edgecollective/uv254/hardware/uv-control/README.md

# UV-Control

Controller board. **v0.4 is in progress on `main`, restarted from Rook v0.4**
(Edge Collective's validated Pro Micro nRF52840 board): its Pro Micro, ST7789
display, buttons and microSD, plus an ADS1115 ADC, JST connectors to the emitter
and detector, and test points. The boost for the UV LED is still to be added. See
[`v0.4-design.md`](v0.4-design.md) for the pin map and what's left to do. The
first v0.4 draft is in [`reference/v0.4-draft`](reference/v0.4-draft).

v0.1 (fabricated in 2024) used an Adafruit ItsyBitsy nRF52840 Express, an
SSD1306 OLED display, push buttons and a 555-based boost circuit.

Firmware is in [`firmware/uv-control`](../../firmware/uv-control). The v0.4
bring-up code is in its [`v0.4`](../../firmware/uv-control/v0.4) folder.

Open `uv-control.kicad_pro` in KiCad 10. Custom parts come from
[`lib/`](../../lib).

**[Download the KiCad files (zip)](https://github.com/edgecollective/uv254/archive/refs/heads/main.zip)**: the whole repository as it is on
`main`, because the board needs the shared `lib/` folder. This board is in
`hardware/uv-control/`.

<!-- render-images:start -->
<!-- Generated by scripts/render-images.sh. Edits between these markers are overwritten. -->

## Schematic

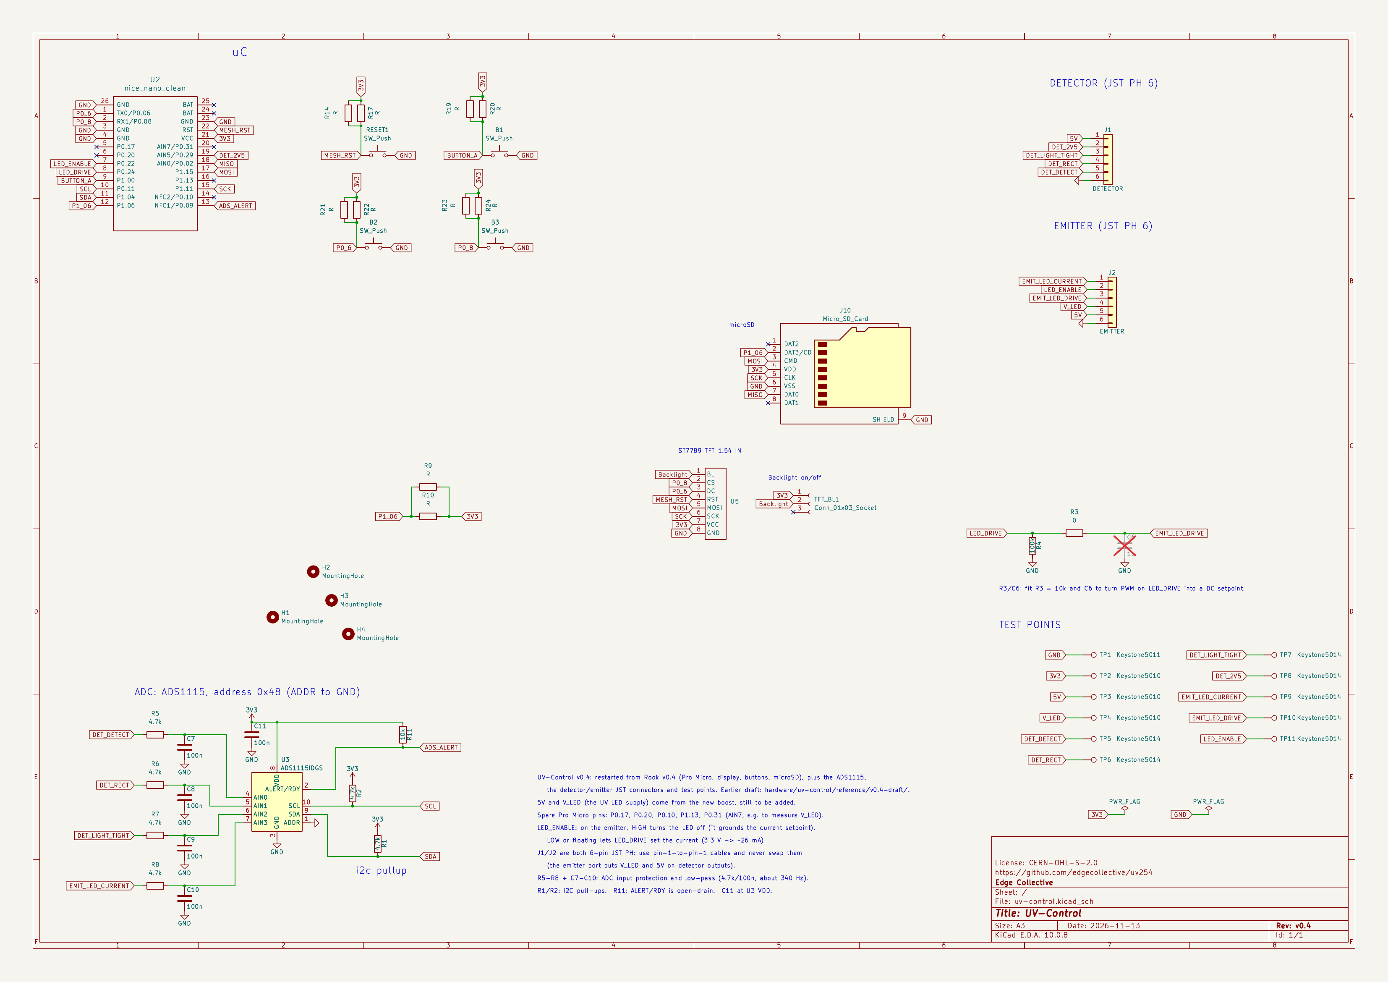
[picture p8: hardware/uv-control/docs/uv-control-schematic.png]
UV-Control schematic


Click the image for the [PDF](docs/uv-control-schematic.pdf).

## Board layout

Copper and silkscreen. The back is mirrored, as seen from below.

| Front | Back |
|:---:|:---:|
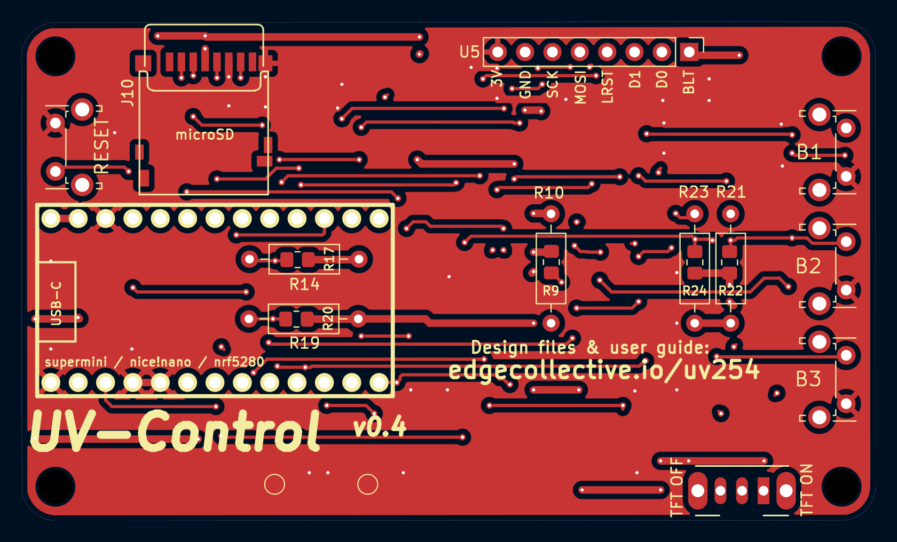
[picture p9: hardware/uv-control/docs/uv-control-pcb-front.png]
UV-Control PCB, front
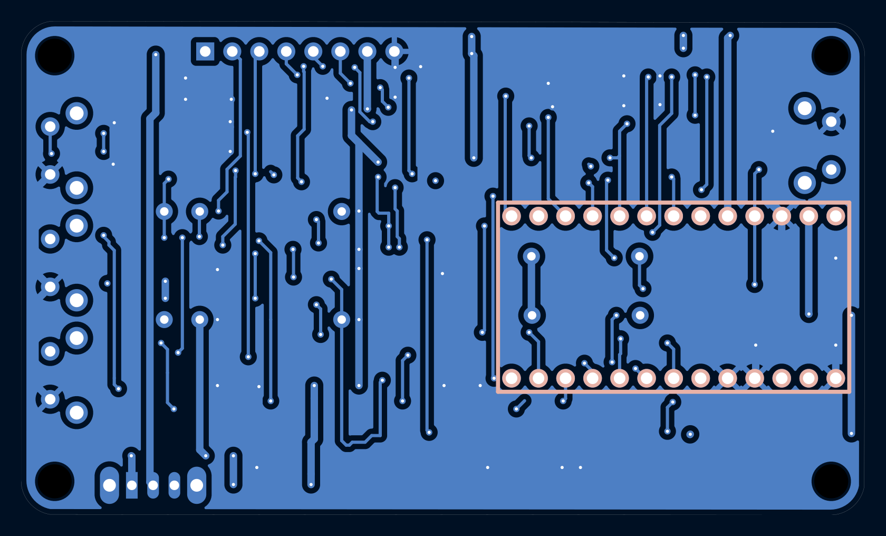
[picture p10: hardware/uv-control/docs/uv-control-pcb-back.png]
UV-Control PCB, back
|  |  |

## 3D view

| Front | Back |
|:---:|:---:|
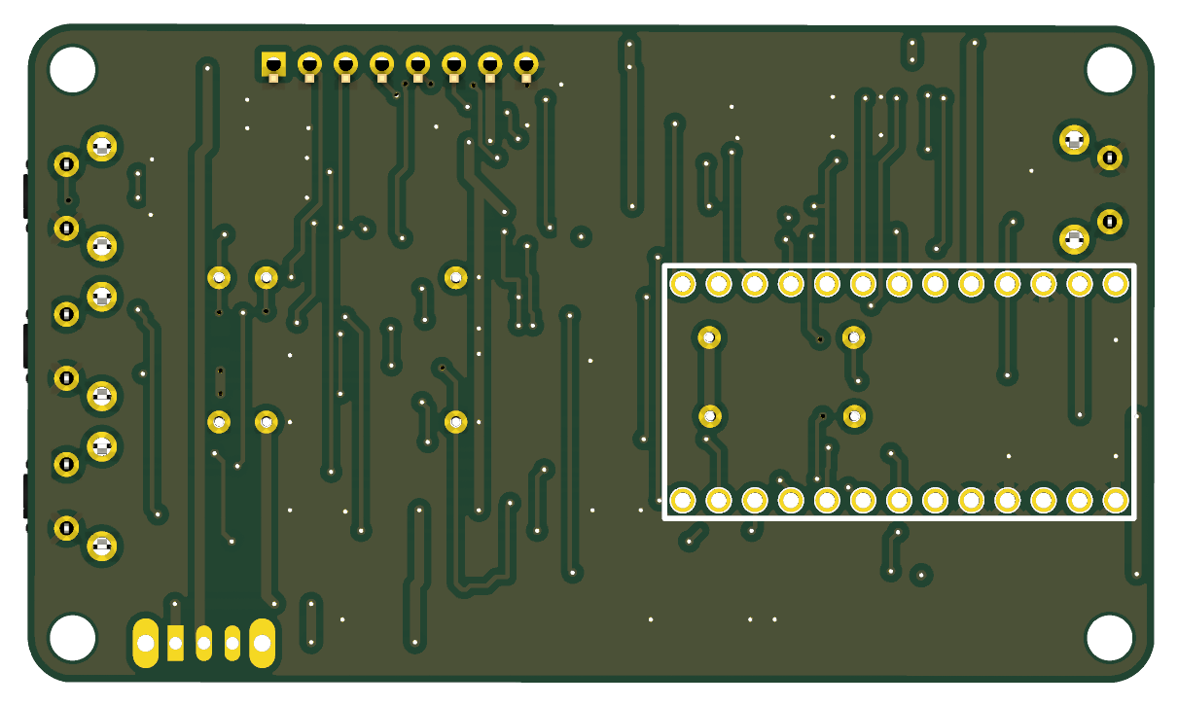
[picture p11: hardware/uv-control/docs/uv-control-3d-back.png]
UV-Control 3D render, back
| UV-Control 3D render, front |  |

Images of the current design, made with `scripts/render-images.sh uv-control`.
Re-run it after changing the board; see
[Updating the board images](../../README.md#updating-the-board-images).
<!-- render-images:end -->

## Revisions

| Version | Date | Status | Design | Fab files |
|---|---|---|---|---|
| v0.1 | 2024-07-29 | gerbers released; ordered from JLCPCB on 2024-08-19 | tag `uv-control/v0.1` | [`fab/v0.1`](fab/v0.1) |
| v0.1_A | 2026-06-26 | branched from v0.1; sent to Josh | tag `uv-control/v0.1_A` | — |
| v0.1_A+ | 2026-10 | edits made after v0.1_A was sent; never fabricated; superseded by v0.4 | commit `db4232b` | — |
| **v0.4** | 2026-11 | **in progress on `main`**: first-draft schematic; layout not started | `main` | — |

Notes:

- **v0.1_A+** isn't tagged. To get it back: `git checkout db4232b -- hardware/uv-control`.
  Its silkscreen points to `gitlab.com/edgecollective/uv-water/` and reads
  `UV-Control v0.1 / July 2024`.
