edgecollective/uv254/hardware/uv-emitter/fab/v0.4/uv-emitter-v0.4-bom.csv

Refs | Value | Footprint | Qty | DNP | Description
CX1 | 0.1 uF | Capacitor_SMD:C_0805_2012Metric_Pad1.18x1.45mm_HandSolder | 1 |  | Unpolarized capacitor
CX2 | 1 uF | Capacitor_SMD:C_0805_2012Metric_Pad1.18x1.45mm_HandSolder | 1 |  | Unpolarized capacitor
D1 | UV LED | uv254:LED_IN-C35PPCTGU0 | 1
H1,H2,H3,H4 | MountingHole | MountingHole:MountingHole_3.2mm_M3 | 4 |  | Mounting Hole without connection
J1 | Conn_01x06_Socket | Connector_PinSocket_2.54mm:PinSocket_1x06_P2.54mm_Vertical | 1 |  | Generic connector, single row, 01x06, script generated
J2 | Conn_01x06_Socket | Connector_JST:JST_PH_B6B-PH-K_1x06_P2.00mm_Vertical | 1 |  | Generic connector, single row, 01x06, script generated
Q1,Q2 | 2N7000 | Package_TO_SOT_SMD:SOT-23 | 2 |  | 0.2A Id, 200V Vds, N-Channel MOSFET, 2.6V Logic Level, TO-92
R1 | 49.9 | Resistor_SMD:R_0805_2012Metric_Pad1.20x1.40mm_HandSolder | 1
R2 | 24.9 | Resistor_SMD:R_0805_2012Metric_Pad1.20x1.40mm_HandSolder | 1
R3 | 100K | Resistor_SMD:R_0805_2012Metric_Pad1.20x1.40mm_HandSolder | 1
R4 | 24.9K | Resistor_SMD:R_0805_2012Metric_Pad1.20x1.40mm_HandSolder | 1
R5 | 10K | Resistor_SMD:R_0805_2012Metric_Pad1.20x1.40mm_HandSolder | 1
U1 | OPA4340UA | Package_SO:SOIC-14_3.9x8.7mm_P1.27mm | 1 |  | Quad Single-Supply, Rail-to-Rail Operational Amplifier, MicroAmplifier Series, SOIC-14
