edgecollective/uv254/hardware/uv-detector/fab/v0.4/uv-detector-v0.4-bom.csv

Refs | Value | Footprint | Qty | DNP | Description
C1,C3,CX4,CX5 | 1uF | Capacitor_SMD:C_0805_2012Metric_Pad1.18x1.45mm_HandSolder | 4
C2 | 10pF | Capacitor_SMD:C_0805_2012Metric_Pad1.18x1.45mm_HandSolder | 1
C4,C5 | 0.1uF | Capacitor_SMD:C_0805_2012Metric_Pad1.18x1.45mm_HandSolder | 2
D1 | BAT54S | Package_TO_SOT_SMD:SOT-23 | 1
D2 | SD008-2171-112 | Package_TO_SOT_THT:TO-18-3 | 1 |  | Si PIN Photodiode, 0.1 GHz, TO-18-3
H1,H2,H3,H4 | MountingHole | MountingHole:MountingHole_3.2mm_M3 | 4 |  | Mounting Hole without connection
J1 | Conn_01x06_Male | Connector_PinHeader_2.54mm:PinHeader_1x06_P2.54mm_Vertical | 1 |  | Generic connector, single row, 01x06, script generated (kicad-library-utils/schlib/autogen/connector/)
J2 | Conn_01x06_Male | Connector_JST:JST_PH_B6B-PH-K_1x06_P2.00mm_Vertical | 1 |  | Generic connector, single row, 01x06, script generated (kicad-library-utils/schlib/autogen/connector/)
R1,R2,R3,R5,R7,R9,R11 | 10K | Resistor_SMD:R_0805_2012Metric_Pad1.20x1.40mm_HandSolder | 7
R4,R15 | 4.99K | Resistor_SMD:R_0805_2012Metric_Pad1.20x1.40mm_HandSolder | 2
R8 | 1Meg | Resistor_SMD:R_0805_2012Metric_Pad1.20x1.40mm_HandSolder | 1
R14,RX13 | 1K | Resistor_SMD:R_0805_2012Metric_Pad1.20x1.40mm_HandSolder | 2
RX6 | 100K | Resistor_SMD:R_0805_2012Metric_Pad1.20x1.40mm_HandSolder | 1
RX10,RX12 | 43.2K | Resistor_SMD:R_0805_2012Metric_Pad1.20x1.40mm_HandSolder | 2
U1 | OPA4340UA | Package_SO:SOIC-14_3.9x8.7mm_P1.27mm | 1
U2 | LM4040DBZ-2.5 | Package_TO_SOT_SMD:SOT-23 | 1 |  | 2.500V Precision Micropower Shunt Voltage Reference, SOT-23
