edgecollective/uv254/hardware/uv-detector/docs/uv-detector-schematic.pdf

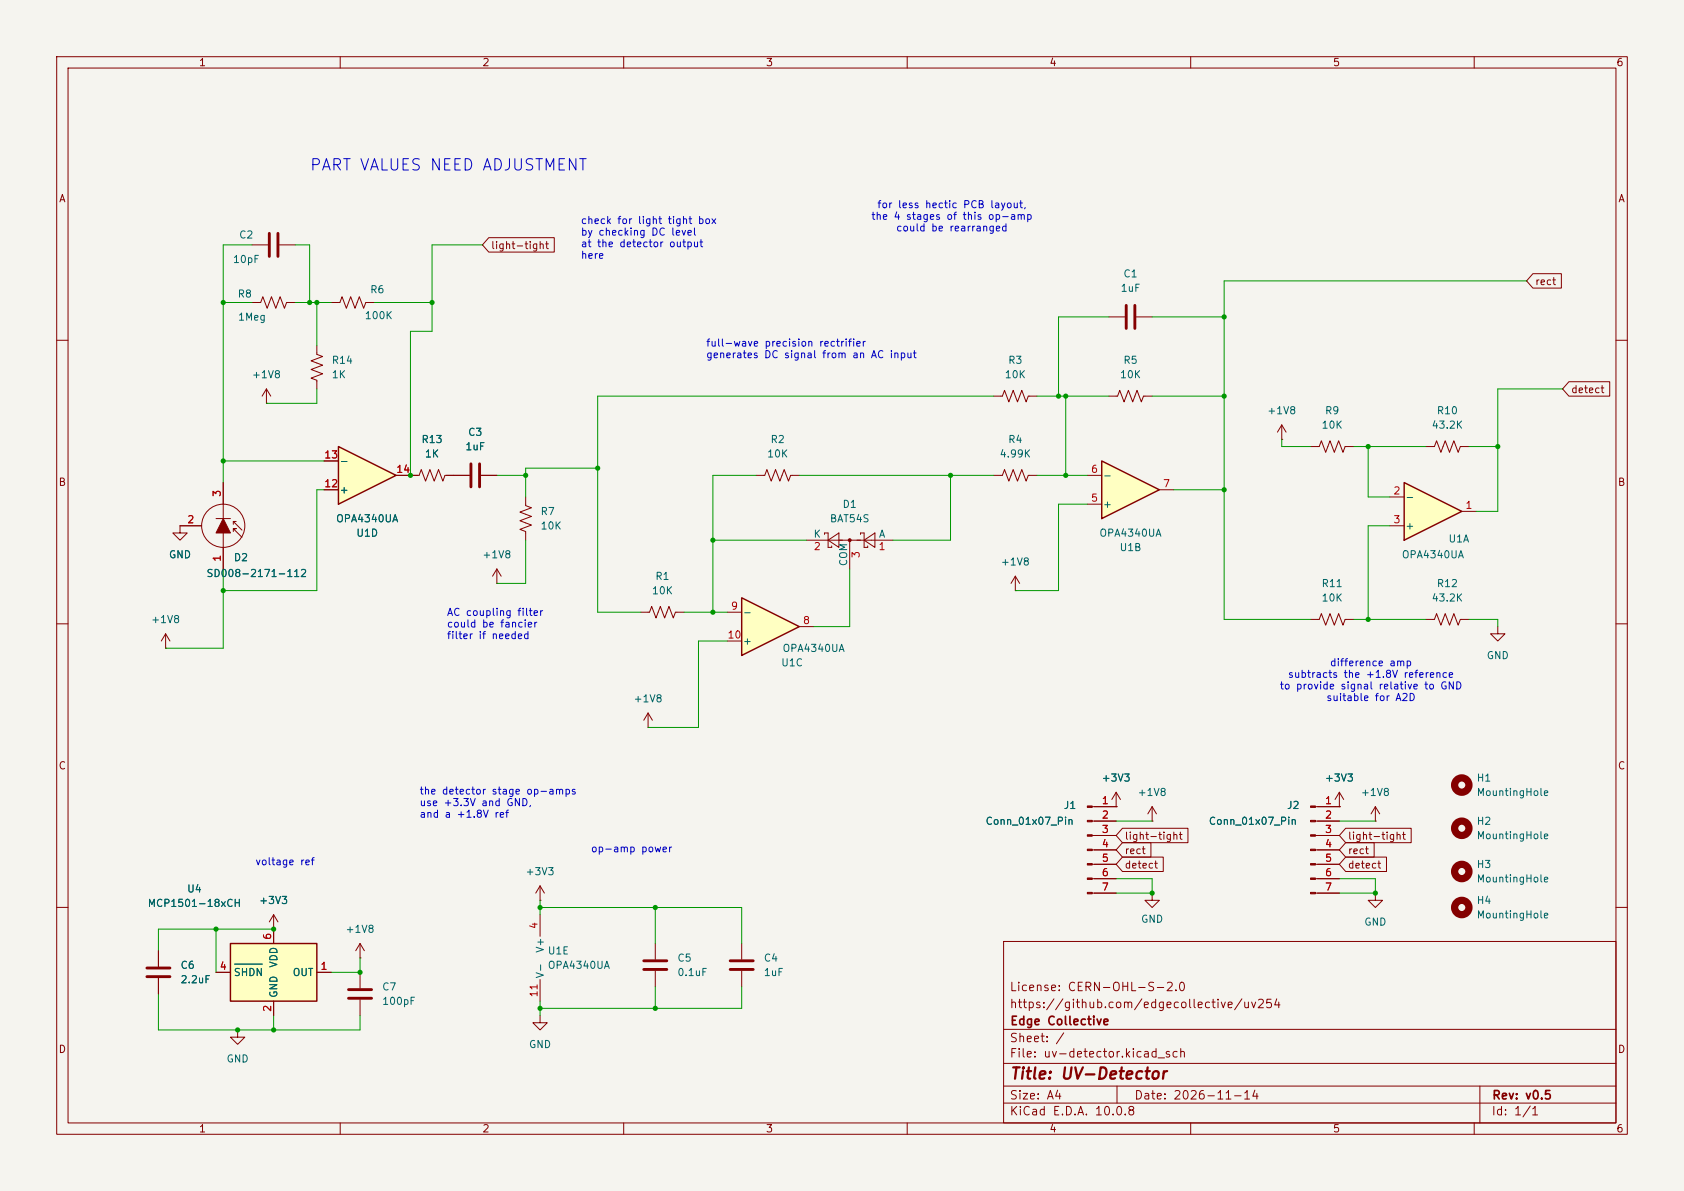
[picture p16: page 1]

PART VALUES NEED ADJUSTMENT

for less hectic PCB layout, the 4 stages of this op-amp

could be rearranged check for light tight box by checking DC level at the detector output here

full-wave precision rectrifier generates DC signal from an AC input AC coupling filter could be fancier

subtracts the +1.8V reference
to provide signal relative to GND

License: CERN-OHL-S-2.0
https://github.com/edgecollective/uv254
Edge Collective
Sheet: /
File: uv-detector.kicad_sch
Title: UV-Detector

Size: A4 | Rev: v0.5
KiCad E.D.A. 10.0.8 | Id: 1/1
