edgecollective/uv254/hardware/uv-control/docs/uv-control-schematic.pdf

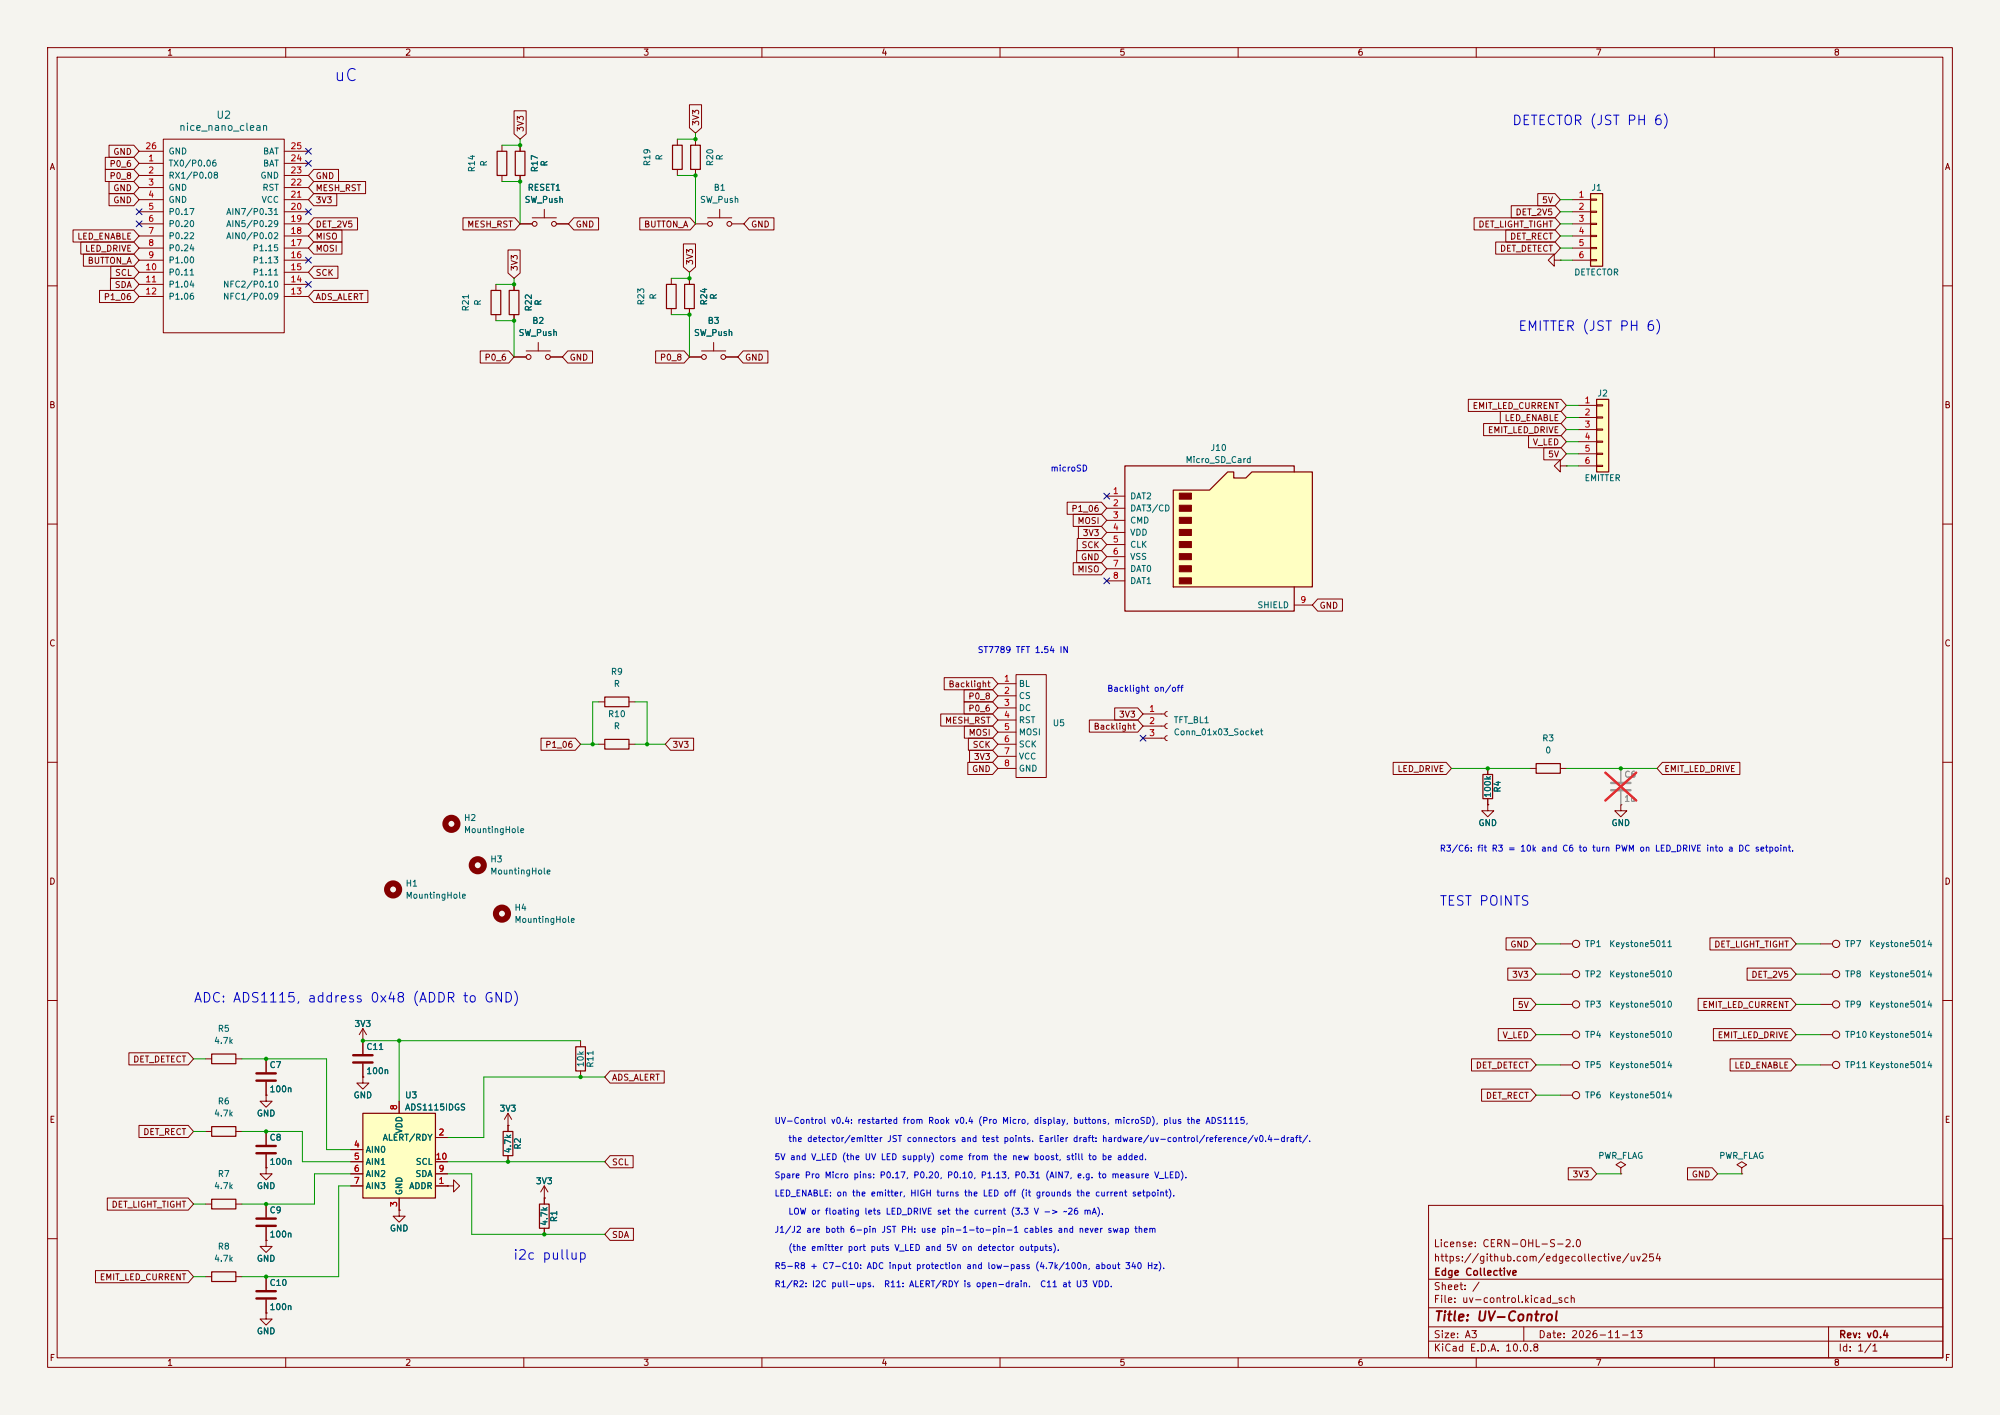
[picture p17: page 1]

R3/C6: fit R3 = 10k and C6 to turn PWM on LED_DRIVE into a DC setpoint.

ADC: ADS1115, address 0x48 (ADDR to GND)
TP9 Keystone5014 R7

GND
5V and V_LED (the UV LED supply) come from the new boost, still to be added. LED_ENABLE: on the emitter, HIGH turns the LED off (it grounds the current setpoint). the detector/emitter JST connectors and test points. Earlier draft: hardware/uv-control/reference/v0.4-draft/. UV-Control v0.4: restarted from Rook v0.4 (Pro Micro, display, buttons, microSD), plus the ADS1115, GND
100n GND

Spare Pro Micro pins: P0.17, P0.20, P0.10, P1.13, P0.31 (AIN7, e.g. to measure V_LED). R5-R8 + C7-C10: ADC input protection and low-pass (4.7k/100n, about 340 Hz).

(the emitter port puts V_LED and 5V on detector outputs). LOW or floating lets LED_DRIVE set the current (3.3 V -> ~26 mA).

J1/J2 are both 6-pin JST PH: use pin-1-to-pin-1 cables and never swap them

License: CERN-OHL-S-2.0
https://github.com/edgecollective/uv254
Edge Collective
Sheet: /
File: uv-control.kicad_sch
Title: UV-Control

Size: A3 | Rev: v0.4 | F Date: 2026-11-13
KiCad E.D.A. 10.0.8 | Id: 1/1
