edgecollective/uv254/hardware/uv-emitter/docs/uv-emitter-schematic.pdf

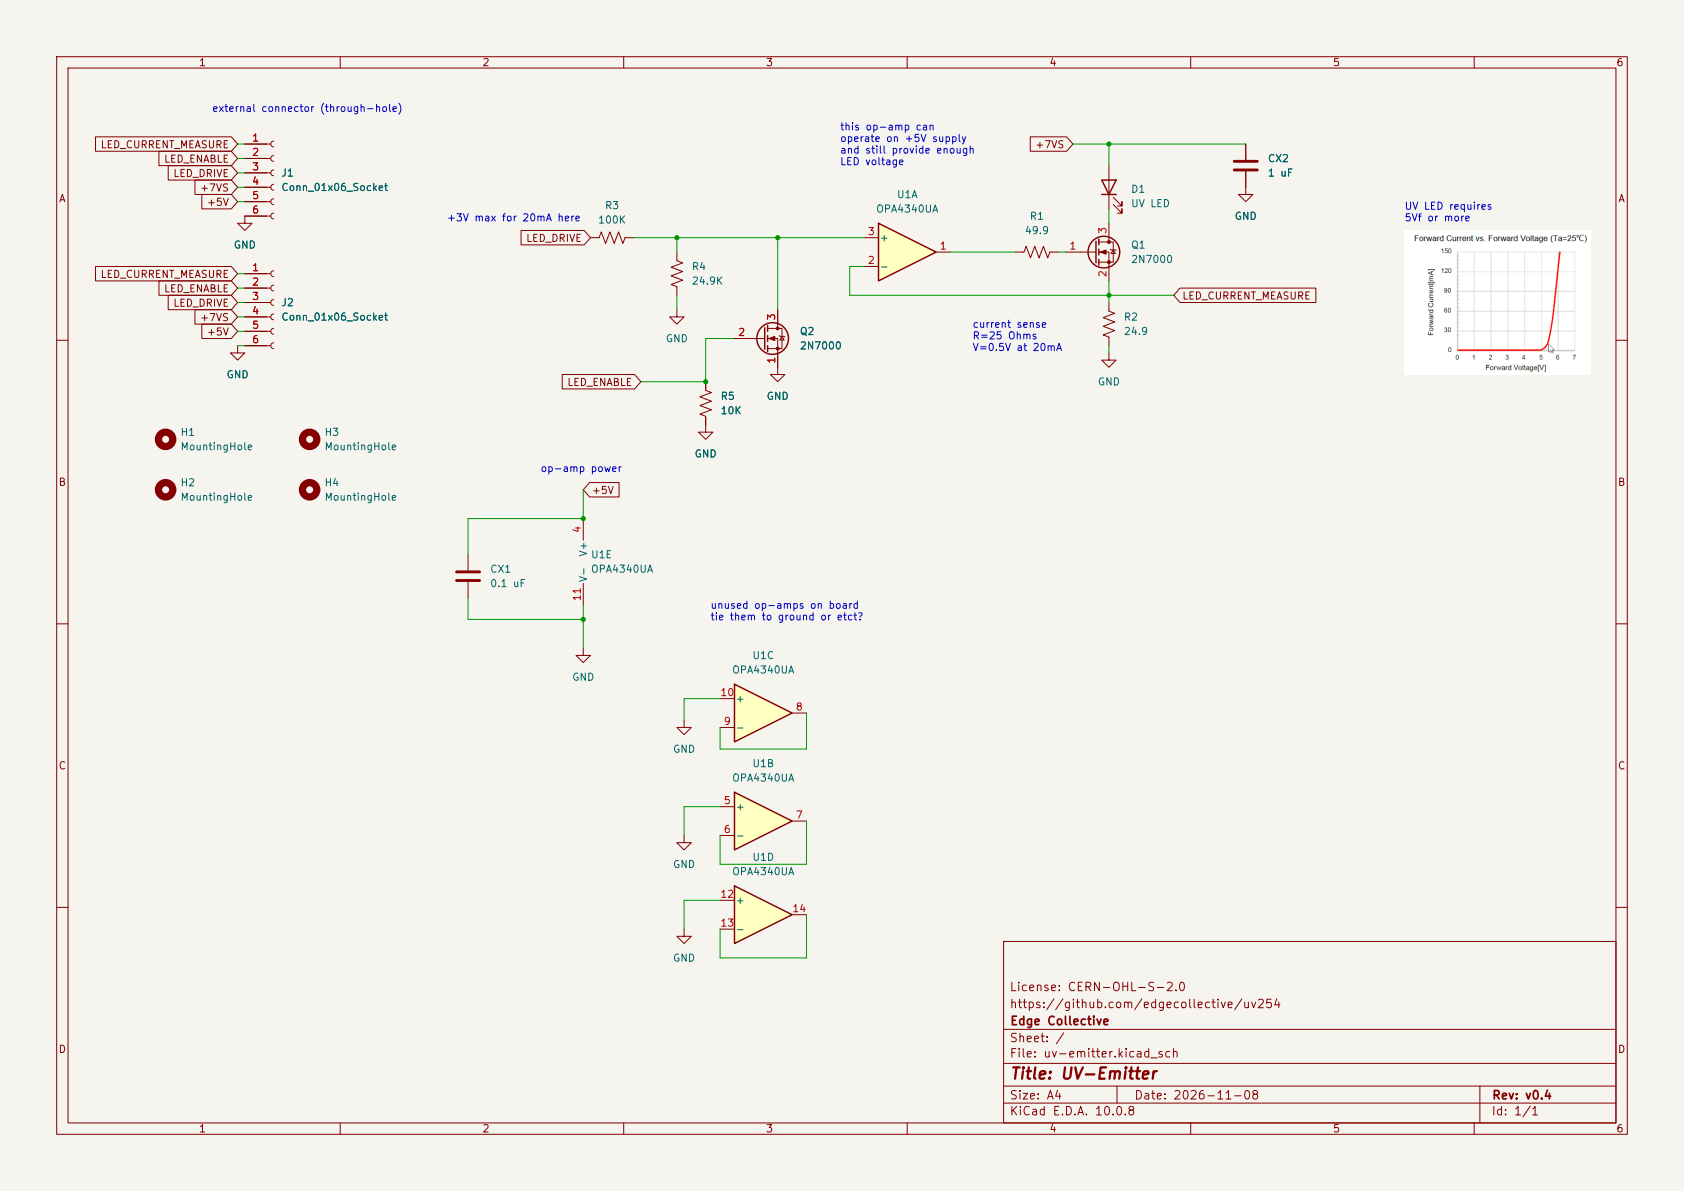
[picture p18: page 1]

this op-amp can

current sense R=25 Ohms V=0.5V at 20mA

tie them to ground or etct?

License: CERN-OHL-S-2.0
https://github.com/edgecollective/uv254
Edge Collective
Sheet: /
File: uv-emitter.kicad_sch
Title: UV-Emitter

Size: A4 | Rev: v0.4
KiCad E.D.A. 10.0.8 | Id: 1/1
