edgecollective/uv254/hardware/uv-detector/fab/v0.4/uv-detector-v0.4-schematic.pdf

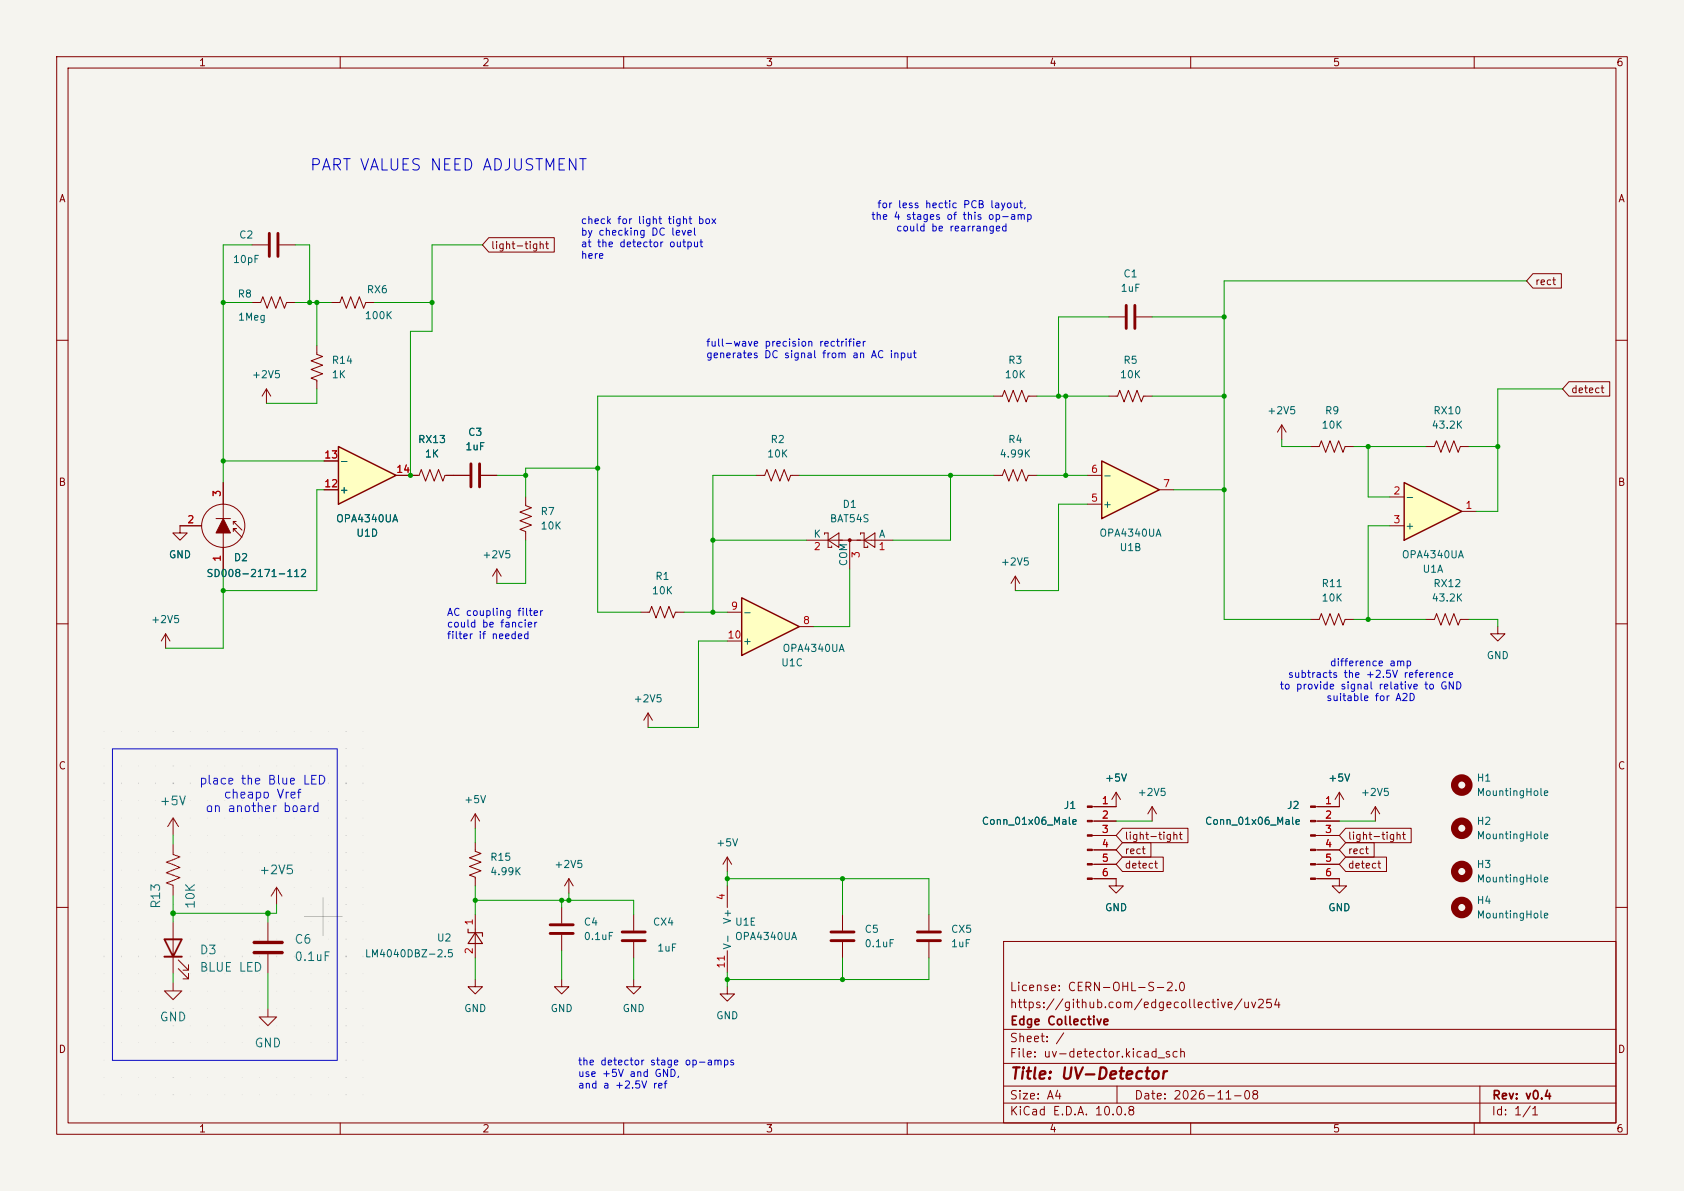
[picture p19: page 1]

PART VALUES NEED ADJUSTMENT

for less hectic PCB layout, the 4 stages of this op-amp

full-wave precision rectrifier generates DC signal from an AC input

light-tight rect AC coupling filter could be fancier

subtracts the +2.5V reference
to provide signal relative to GND

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

the detector stage op-amps use +5V and GND, and a +2.5V ref

Size: A4 | Rev: v0.4
KiCad E.D.A. 10.0.8 | Id: 1/1
