edgecollective/uv254/hardware/uv-detector/uv-detector.kicad_pcb

## KiCad design hardware/uv-detector/uv-detector.kicad_pcb (2026-11-14)

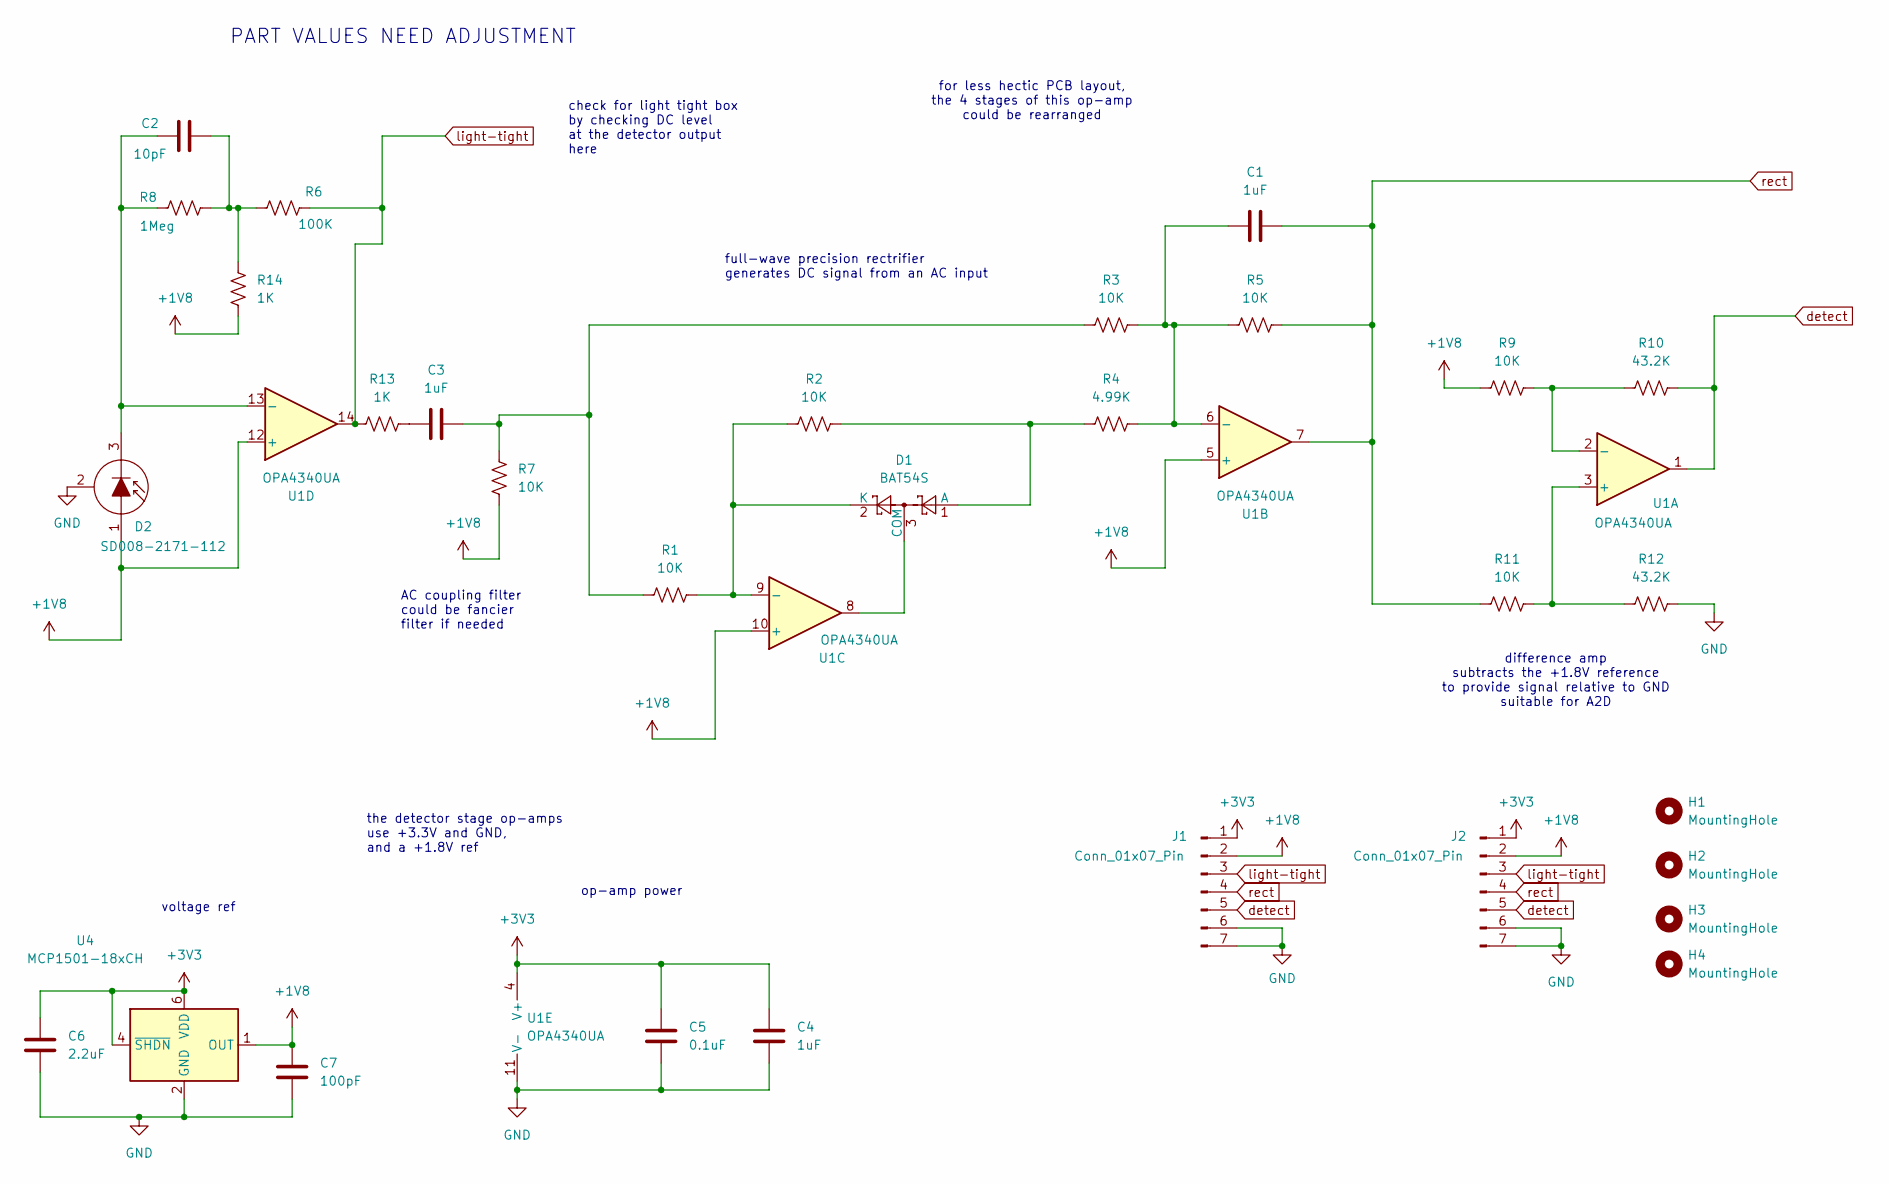
[picture p20: schematic uv-detector.kicad_sch]

Parts:
C1, C3, C4: 1uF; C_0805_2012Metric_Pad1.18x1.45mm_HandSolder
C2: 10pF; C_0805_2012Metric_Pad1.18x1.45mm_HandSolder
C5: 0.1uF; C_0805_2012Metric_Pad1.18x1.45mm_HandSolder
C6: 2.2uF; C_0805_2012Metric_Pad1.18x1.45mm_HandSolder
C7: 100pF; C_0805_2012Metric_Pad1.18x1.45mm_HandSolder
D1: BAT54S; SOT-23
D2: SD008-2171-112; TO-18-3
H1, H2, H3, H4: MountingHole; MountingHole_3.2mm_M3
J1: Conn_01x07_Pin; PinHeader_1x07_P2.54mm_Vertical
J2: Conn_01x07_Pin; JST_PH_B7B-PH-K_1x07_P2.00mm_Vertical
R1, R2, R3, R5, R7, R9, R11: 10K; R_0805_2012Metric_Pad1.20x1.40mm_HandSolder
R4: 4.99K; R_0805_2012Metric_Pad1.20x1.40mm_HandSolder
R6: 100K; R_0805_2012Metric_Pad1.20x1.40mm_HandSolder
R8: 1Meg; R_0805_2012Metric_Pad1.20x1.40mm_HandSolder
R10, R12: 43.2K; R_0805_2012Metric_Pad1.20x1.40mm_HandSolder
R13, R14: 1K; R_0805_2012Metric_Pad1.20x1.40mm_HandSolder
U1: OPA4340UA; SOIC-14_3.9x8.7mm_P1.27mm
U4: MCP1501-18xCH; SOT-23-6

Connections:
+1V8: C7.2, D2.1, J1.2, J2.2, R7.1, R9.1, R14.1, U1.5 (+), U1.10 (+), U1.12 (+), U4.1 (OUT)
+3V3: C4.2, C5.2, C6.2, J1.1, J2.1, U1.4 (V+), U4.4 (~SHDN), U4.6 (VDD)
GND: C4.1, C5.1, C6.1, C7.1, D2.2 (C), J1.6, J1.7, J2.6, J2.7, R12.2, U1.11 (V-), U4.2 (GND), U4.3 (GND), U4.5 (GND)
unnamed: C2.2, R6.1, R8.2, R14.2
unnamed: C3.1, R13.1
unnamed: C3.2, R1.1, R3.1, R7.2
unnamed: D1.1 (A), R2.2, R4.1
unnamed: D1.3 (COM), U1.8
unnamed: D1.2 (K), R1.2, R2.1, U1.9 (-)
unnamed: C2.1, D2.3 (K), R8.1, U1.13 (-)
unnamed: R11.2, R12.1, U1.3 (+)
unnamed: R9.2, R10.1, U1.2 (-)
unnamed: C1.1, R3.2, R4.2, R5.1, U1.6 (-)
detect: J1.5, J2.5, R10.2, U1.1
light-tight: J1.3, J2.3, R6.2, R13.2, U1.14
rect: C1.2, J1.4, J2.4, R5.2, R11.1, U1.7

Notes on the sheet:
PART VALUES NEED ADJUSTMENT
op-amp power
for less hectic PCB layout, the 4 stages of this op-amp could be rearranged
full-wave precision rectrifier generates DC signal from an AC input
AC coupling filter could be fancier filter if needed
voltage ref
check for light tight box by checking DC level at the detector output here
the detector stage op-amps use +3.3V and GND, and a +1.8V ref
difference amp subtracts the +1.8V reference to provide signal relative to GND suitable for A2D

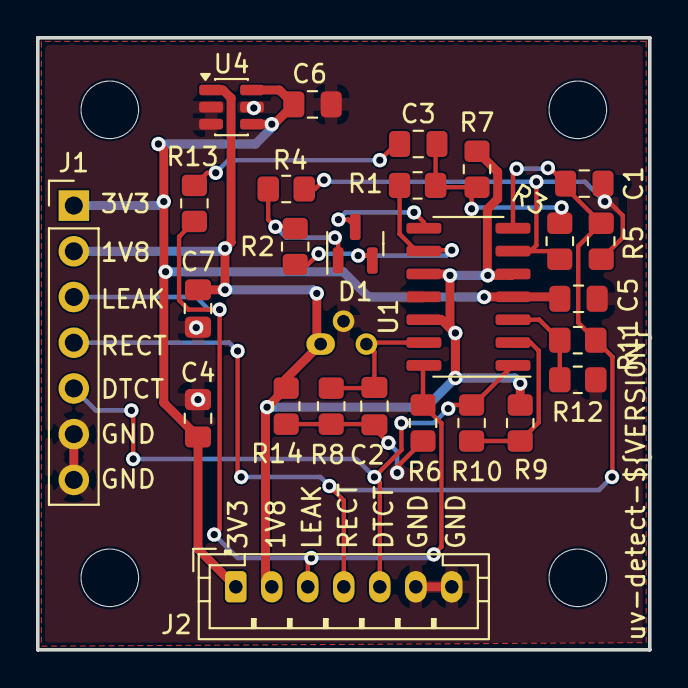
[picture p21: board uv-detector.kicad_pcb from above]

Board: 2 copper layers, 34.0 x 34.0 mm, 31 parts (1 on the bottom side), 16 nets.
