edgecollective/uv254/hardware/uv-control/uv-control.kicad_pcb

## KiCad design hardware/uv-control/uv-control.kicad_pcb (2026-11-14)

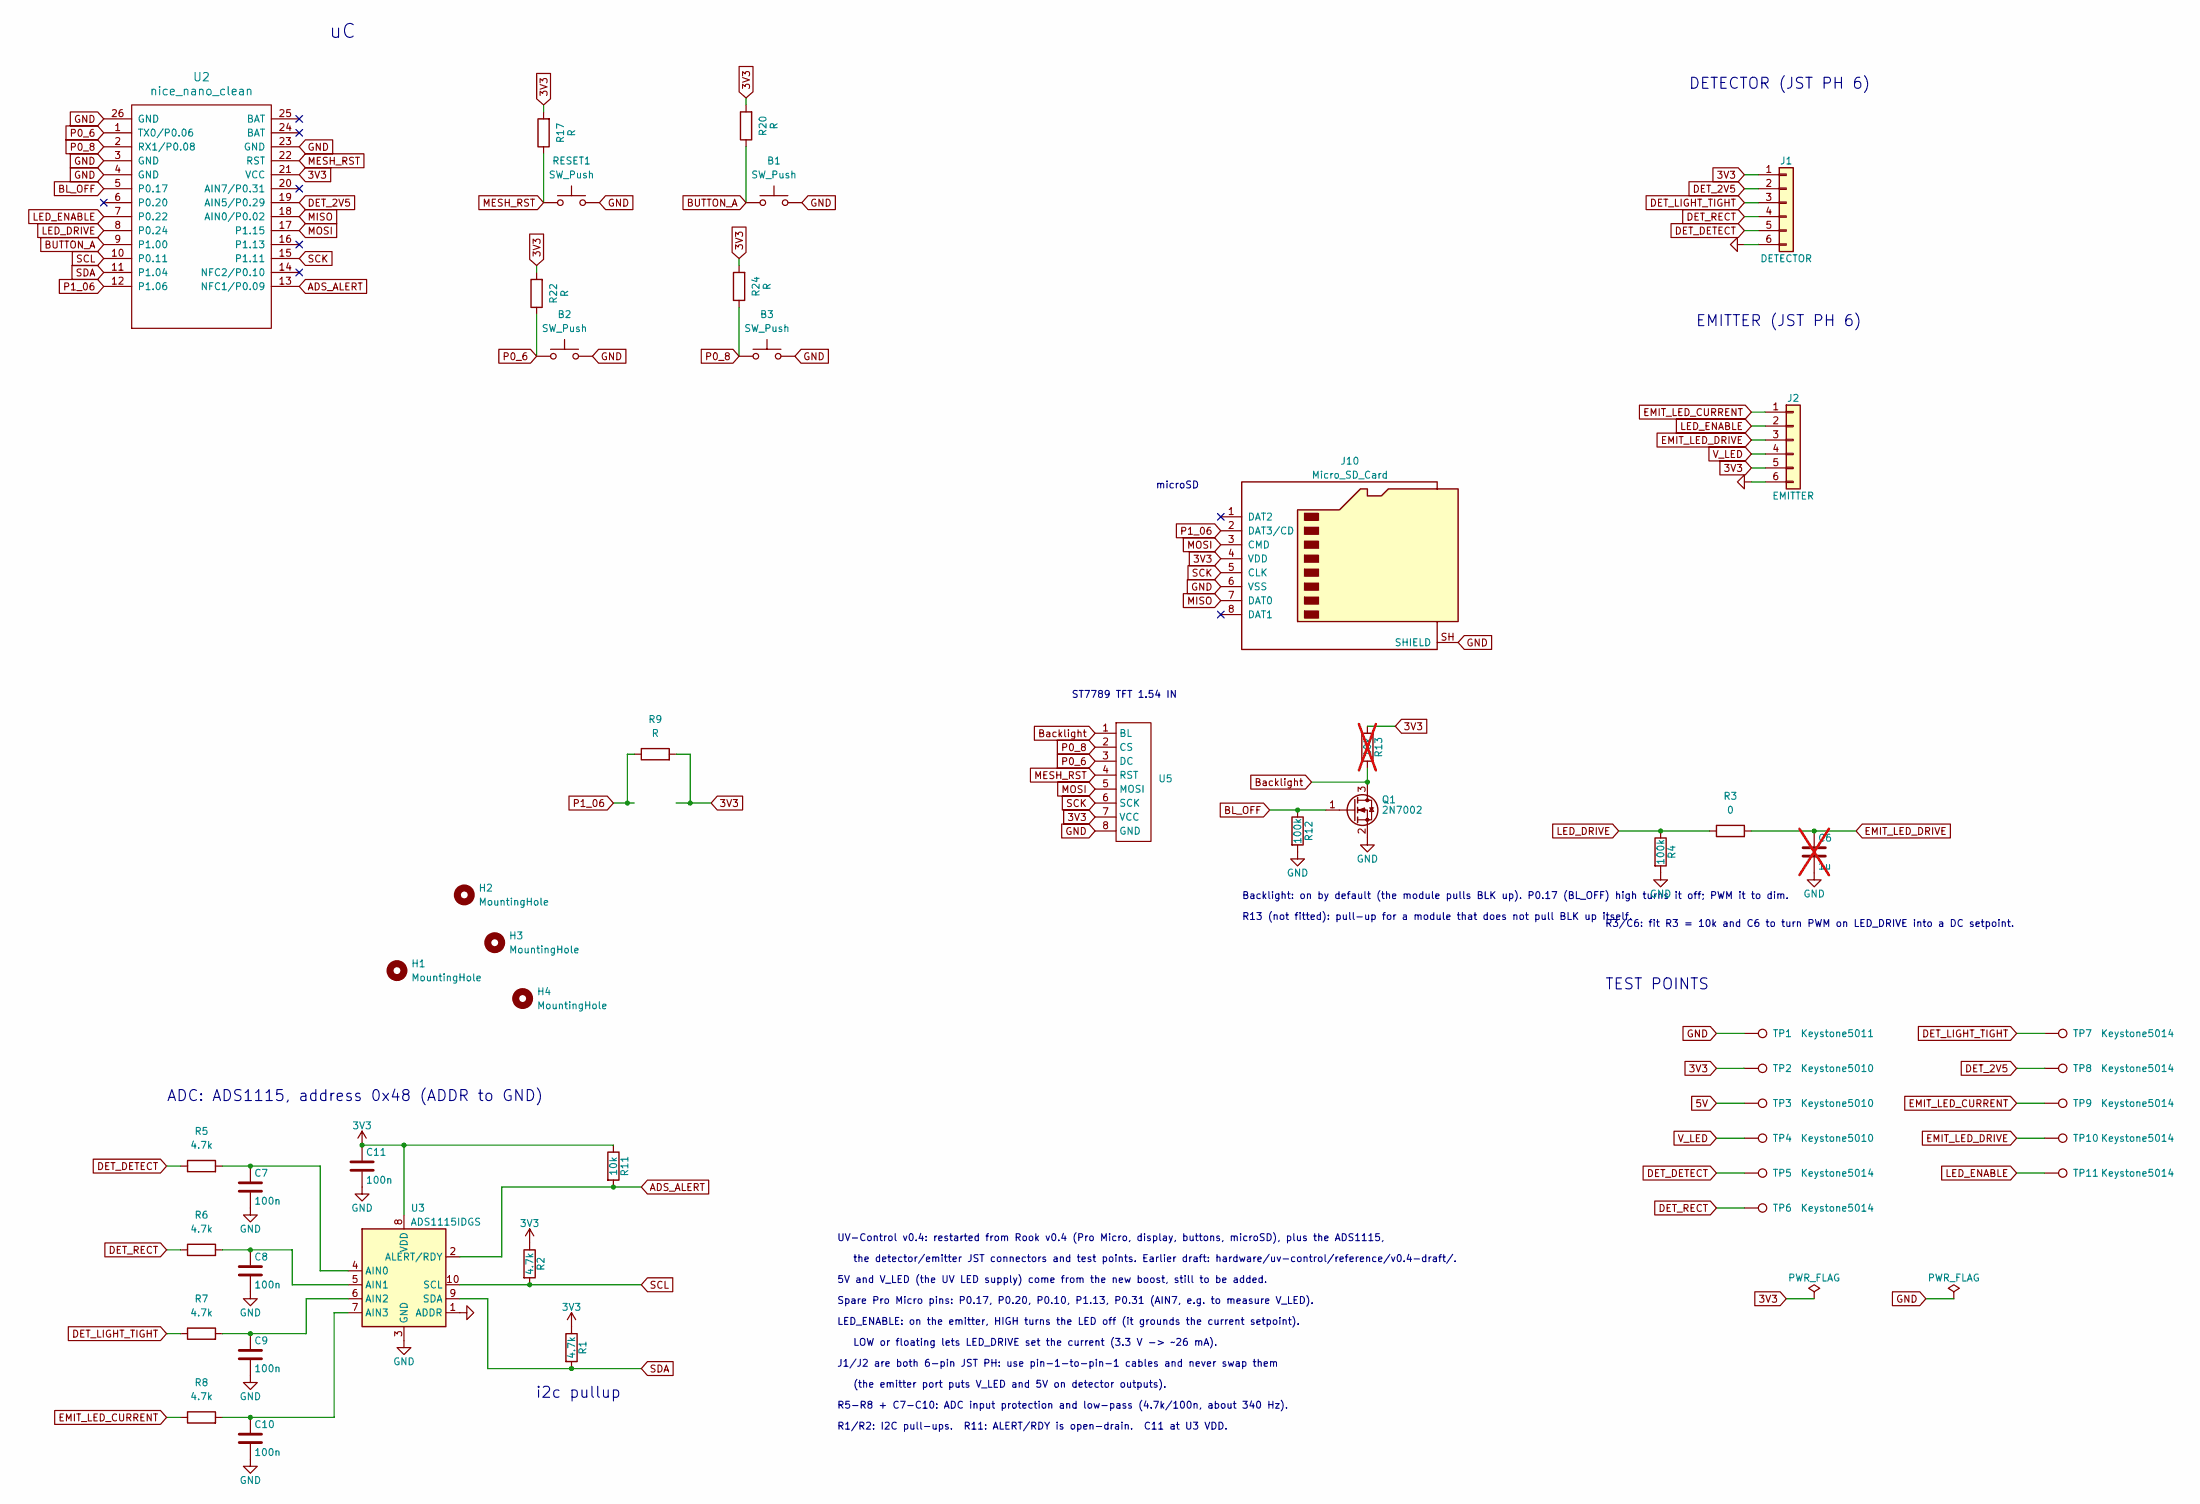
[picture p22: schematic uv-control.kicad_sch]

Parts:
B1, B2, B3: SW_Push; SW_Tactile_12x12_B3F-40xx
C6: 1u; C_0805_2012Metric; not fitted
C7, C8, C9, C10, C11: 100n; C_0805_2012Metric
H1, H2, H3, H4: MountingHole; MountingHole_3.2mm_M3
J1: DETECTOR; JST_PH_B6B-PH-K_1x06_P2.00mm_Vertical
J2: EMITTER; JST_PH_B6B-PH-K_1x06_P2.00mm_Vertical
J10: Micro_SD_Card; DM3D-SF_outline
Q1: 2N7002; SOT-23
R1, R2, R5, R6, R7, R8: 4.7k; R_0805_2012Metric
R3: 0; R_0805_2012Metric
R4, R12: 100k; R_0805_2012Metric
R9, R17, R20, R22, R24: R; R_0805_2012Metric_Pad1.20x1.40mm_HandSolder
R11: 10k; R_0805_2012Metric
R13: 10k; R_0805_2012Metric; not fitted
RESET1: SW_Push; SW_PUSH_6mm_H5mm
TP1: Keystone5011; TestPoint_Keystone_5010-5014_Multipurpose
TP2, TP3, TP4: Keystone5010; TestPoint_Keystone_5010-5014_Multipurpose
TP5, TP6, TP7, TP8, TP9, TP10, TP11: Keystone5014; TestPoint_Keystone_5010-5014_Multipurpose
U2: nice_nano_clean; nice_nano_cleanest
U3: ADS1115IDGS; TSSOP-10_3x3mm_P0.5mm
U5: st7789_154in_240x240

Connections:
3V3: C11.1, J1.1, J2.5, J10.4 (VDD), R1.1, R2.1, R9.2, R11.1, R13.1, R17.2, R20.2, R22.2, R24.2, TP2.1 (1_1), U2.21 (VCC), U3.8 (VDD), U5.7 (VCC)
5V: TP3.1 (1_1)
ADS_ALERT: R11.2, U2.13 (NFC1/P0.09), U3.2 (ALERT/RDY)
BL_OFF: Q1.1 (G), R12.1, U2.5 (P0.17)
BUTTON_A: B1.1, R20.1, U2.9 (P1.00)
Backlight: Q1.3 (D), R13.2, U5.1 (BL)
DET_2V5: J1.2, TP8.1 (1_1), U2.19 (AIN5/P0.29)
DET_DETECT: J1.5, R5.1, TP5.1 (1_1)
DET_LIGHT_TIGHT: J1.3, R7.1, TP7.1 (1_1)
DET_RECT: J1.4, R6.1, TP6.1 (1_1)
EMIT_LED_CURRENT: J2.1, R8.1, TP9.1 (1_1)
EMIT_LED_DRIVE: C6.1, J2.3, R3.2, TP10.1 (1_1)
GND: B1.2, B2.2, B3.2, C6.2, C7.2, C8.2, C9.2, C10.2, C11.2, J1.6, J2.6, J10.6 (VSS), J10.SH (SHIELD), Q1.2 (S), R4.2, R12.2, RESET1.2, TP1.1 (1_1), U2.3 (GND), U2.4 (GND), U2.23 (GND), U2.26 (GND), U3.1 (ADDR), U3.3 (GND), U5.8 (GND)
LED_DRIVE: R3.1, R4.1, U2.8 (P0.24)
LED_ENABLE: J2.2, TP11.1 (1_1), U2.7 (P0.22)
MESH_RST: R17.1, RESET1.1, U2.22 (RST), U5.4 (RST)
MISO: J10.7 (DAT0), U2.18 (AIN0/P0.02)
MOSI: J10.3 (CMD), U2.17 (P1.15), U5.5 (MOSI)
unnamed: C7.1, R5.2, U3.4 (AIN0)
unnamed: C8.1, R6.2, U3.5 (AIN1)
unnamed: C9.1, R7.2, U3.6 (AIN2)
unnamed: C10.1, R8.2, U3.7 (AIN3)
P0_6: B2.1, R22.1, U2.1 (TX0/P0.06), U5.3 (DC)
P0_8: B3.1, R24.1, U2.2 (RX1/P0.08), U5.2 (CS)
P1_06: J10.2 (DAT3/CD), R9.1, U2.12 (P1.06)
SCK: J10.5 (CLK), U2.15 (P1.11), U5.6 (SCK)
SCL: R2.2, U2.10 (P0.11), U3.10 (SCL)
SDA: R1.2, U2.11 (P1.04), U3.9 (SDA)
V_LED: J2.4, TP4.1 (1_1)

Notes on the sheet:
microSD
EMITTER (JST PH 6)
TEST POINTS
5V and V_LED (the UV LED supply) come from the new boost, still to be added.
ADC: ADS1115, address 0x48 (ADDR to GND)
R5-R8 + C7-C10: ADC input protection and low-pass (4.7k/100n, about 340 Hz).
ST7789 TFT 1.54 IN
J1/J2 are both 6-pin JST PH: use pin-1-to-pin-1 cables and never swap them
i2c pullup
Spare Pro Micro pins: P0.17, P0.20, P0.10, P1.13, P0.31 (AIN7, e.g. to measure V_LED).
DETECTOR (JST PH 6)
UV-Control v0.4: restarted from Rook v0.4 (Pro Micro, display, buttons, microSD), plus the ADS1115,
R3/C6: fit R3 = 10k and C6 to turn PWM on LED_DRIVE into a DC setpoint.
Backlight: on by default (the module pulls BLK up). P0.17 (BL_OFF) high turns it off; PWM it to dim.
R1/R2: I2C pull-ups. R11: ALERT/RDY is open-drain. C11 at U3 VDD.
the detector/emitter JST connectors and test points. Earlier draft: hardware/uv-control/reference/v0.4-draft/.
R13 (not fitted): pull-up for a module that does not pull BLK up itself.
LED_ENABLE: on the emitter, HIGH turns the LED off (it grounds the current setpoint).
LOW or floating lets LED_DRIVE set the current (3.3 V -> ~26 mA).
(the emitter port puts V_LED and 5V on detector outputs).

Board: 2 copper layers, 48 parts (39 on the bottom side), 28 nets, no tracks yet.
