edgecollective/uv254/hardware/uv-control/reference/v0.4-draft/uv-control.kicad_pcb

## KiCad design hardware/uv-control/reference/v0.4-draft/uv-control.kicad_pcb (2026-11-13)

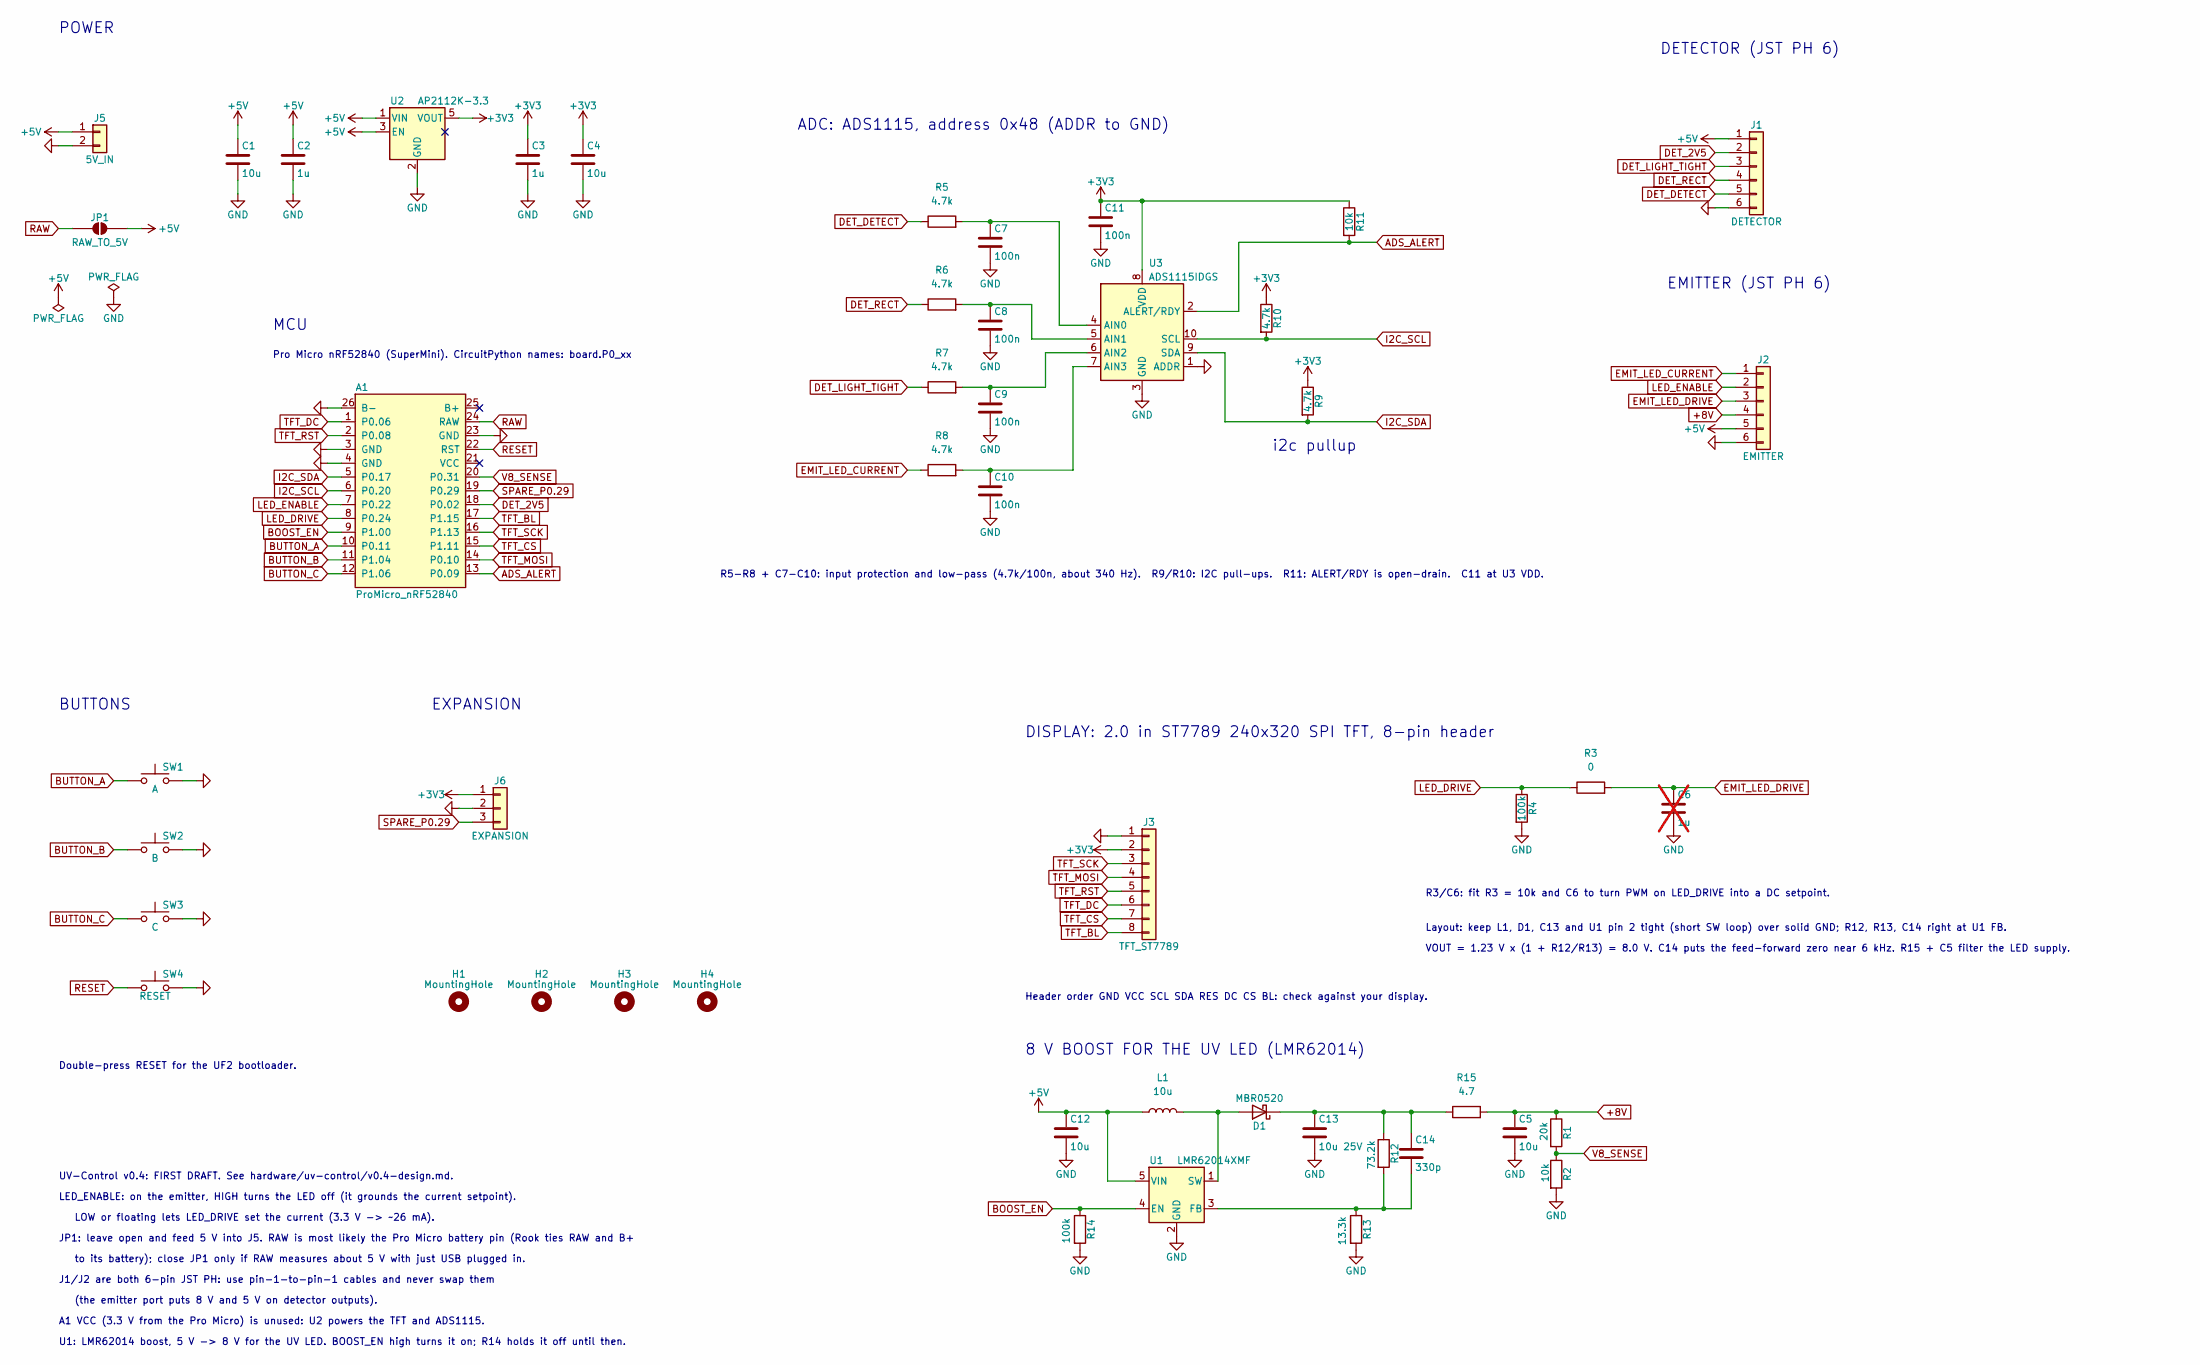
[picture p23: schematic uv-control.kicad_sch]

Parts:
A1: ProMicro_nRF52840
C1, C4, C5, C12: 10u; C_0805_2012Metric
C2, C3: 1u; C_0805_2012Metric
C6: 1u; C_0805_2012Metric; not fitted
C7, C8, C9, C10, C11: 100n; C_0805_2012Metric
C13: 10u 25V; C_1206_3216Metric
C14: 330p; C_0805_2012Metric
D1: MBR0520; D_SOD-123
H1, H2, H3, H4: MountingHole; MountingHole_3.2mm_M3
J1: DETECTOR; JST_PH_B6B-PH-K_1x06_P2.00mm_Vertical
J2: EMITTER; JST_PH_B6B-PH-K_1x06_P2.00mm_Vertical
J3: TFT_ST7789; PinHeader_1x08_P2.54mm_Vertical
J5: 5V_IN; JST_PH_B2B-PH-K_1x02_P2.00mm_Vertical
J6: EXPANSION; PinHeader_1x03_P2.54mm_Vertical
JP1: RAW_TO_5V; SolderJumper-2_P1.3mm_Open_Pad1.0x1.5mm
L1: 10u; L_Bourns-SRN4018
R1: 20k; R_0805_2012Metric
R2, R11: 10k; R_0805_2012Metric
R3: 0; R_0805_2012Metric
R4, R14: 100k; R_0805_2012Metric
R5, R6, R7, R8, R9, R10: 4.7k; R_0805_2012Metric
R12: 73.2k; R_0805_2012Metric
R13: 13.3k; R_0805_2012Metric
R15: 4.7; R_0805_2012Metric
SW1: A; SW_Tactile_SPST_Angled_PTS645Vx31-2LFS
SW2: B; SW_Tactile_SPST_Angled_PTS645Vx31-2LFS
SW3: C; SW_Tactile_SPST_Angled_PTS645Vx31-2LFS
SW4: RESET; SW_Tactile_SPST_Angled_PTS645Vx31-2LFS
U1: LMR62014XMF; SOT-23-5
U2: AP2112K-3.3; SOT-23-5
U3: ADS1115IDGS; TSSOP-10_3x3mm_P0.5mm

Connections:
+3V3: C3.1, C4.1, C11.1, J3.2, J6.1, R9.1, R10.1, R11.1, U2.5 (VOUT), U3.8 (VDD)
+5V: C1.1, C2.1, C12.1, J1.1, J2.5, J5.1, JP1.2 (B), L1.1, U1.5 (VIN), U2.1 (VIN), U2.3 (EN)
+8V: C5.1, J2.4, R1.1, R15.2
ADS_ALERT: A1.13 (P0.09), R11.2, U3.2 (ALERT/RDY)
BOOST_EN: A1.9 (P1.00), R14.1, U1.4 (EN)
BUTTON_A: A1.10 (P0.11), SW1.1
BUTTON_B: A1.11 (P1.04), SW2.1
BUTTON_C: A1.12 (P1.06), SW3.1
DET_2V5: A1.18 (P0.02), J1.2
DET_DETECT: J1.5, R5.1
DET_LIGHT_TIGHT: J1.3, R7.1
DET_RECT: J1.4, R6.1
EMIT_LED_CURRENT: J2.1, R8.1
EMIT_LED_DRIVE: C6.1, J2.3, R3.2
GND: A1.3 (GND), A1.4 (GND), A1.23 (GND), A1.26 (B-), C1.2, C2.2, C3.2, C4.2, C5.2, C6.2, C7.2, C8.2, C9.2, C10.2, C11.2, C12.2, C13.2, J1.6, J2.6, J3.1, J5.2, J6.2, R2.2, R4.2, R13.2, R14.2, SW1.2, SW2.2, SW3.2, SW4.2, U1.2 (GND), U2.2 (GND), U3.1 (ADDR), U3.3 (GND)
I2C_SCL: A1.6 (P0.20), R10.2, U3.10 (SCL)
I2C_SDA: A1.5 (P0.17), R9.2, U3.9 (SDA)
LED_DRIVE: A1.8 (P0.24), R3.1, R4.1
LED_ENABLE: A1.7 (P0.22), J2.2
unnamed: D1.2 (A), L1.2, U1.1 (SW)
unnamed: C13.1, C14.1, D1.1 (K), R12.1, R15.1
unnamed: C14.2, R12.2, R13.1, U1.3 (FB)
unnamed: C7.1, R5.2, U3.4 (AIN0)
unnamed: C8.1, R6.2, U3.5 (AIN1)
unnamed: C9.1, R7.2, U3.6 (AIN2)
unnamed: C10.1, R8.2, U3.7 (AIN3)
RAW: A1.24 (RAW), JP1.1 (A)
RESET: A1.22 (RST), SW4.1
SPARE_P0.29: A1.19 (P0.29), J6.3
TFT_BL: A1.17 (P1.15), J3.8
TFT_CS: A1.15 (P1.11), J3.7
TFT_DC: A1.1 (P0.06), J3.6
TFT_MOSI: A1.14 (P0.10), J3.4
TFT_RST: A1.2 (P0.08), J3.5
TFT_SCK: A1.16 (P1.13), J3.3
V8_SENSE: A1.20 (P0.31), R1.2, R2.1

Notes on the sheet:
UV-Control v0.4: FIRST DRAFT. See hardware/uv-control/v0.4-design.md.
VOUT = 1.23 V x (1 + R12/R13) = 8.0 V. C14 puts the feed-forward zero near 6 kHz. R15 + C5 filter the LED supply.
Double-press RESET for the UF2 bootloader.
POWER
Header order GND VCC SCL SDA RES DC CS BL: check against your display.
to its battery); close JP1 only if RAW measures about 5 V with just USB plugged in.
EMITTER (JST PH 6)
(the emitter port puts 8 V and 5 V on detector outputs).
ADC: ADS1115, address 0x48 (ADDR to GND)
BUTTONS
Pro Micro nRF52840 (SuperMini). CircuitPython names: board.P0_xx
R5-R8 + C7-C10: input protection and low-pass (4.7k/100n, about 340 Hz). R9/R10: I2C pull-ups. R11: ALERT/RDY is open-drain. C11 at U3 VDD.
A1 VCC (3.3 V from the Pro Micro) is unused: U2 powers the TFT and ADS1115.
i2c pullup
DETECTOR (JST PH 6)
R3/C6: fit R3 = 10k and C6 to turn PWM on LED_DRIVE into a DC setpoint.
LOW or floating lets LED_DRIVE set the current (3.3 V -> ~26 mA).
Layout: keep L1, D1, C13 and U1 pin 2 tight (short SW loop) over solid GND; R12, R13, C14 right at U1 FB.
JP1: leave open and feed 5 V into J5. RAW is most likely the Pro Micro battery pin (Rook ties RAW and B+
EXPANSION
LED_ENABLE: on the emitter, HIGH turns the LED off (it grounds the current setpoint).
J1/J2 are both 6-pin JST PH: use pin-1-to-pin-1 cables and never swap them
MCU
U1: LMR62014 boost, 5 V -> 8 V for the UV LED. BOOST_EN high turns it on; R14 holds it off until then.
8 V BOOST FOR THE UV LED (LMR62014)
DISPLAY: 2.0 in ST7789 240x320 SPI TFT, 8-pin header

Board: 2 copper layers, 49 parts (0 on the bottom side), 36 nets, no tracks yet.
