edgecollective/uv254/hardware/uv-emitter/uv-emitter.kicad_pcb

## KiCad design hardware/uv-emitter/uv-emitter.kicad_pcb (2026-11-08)

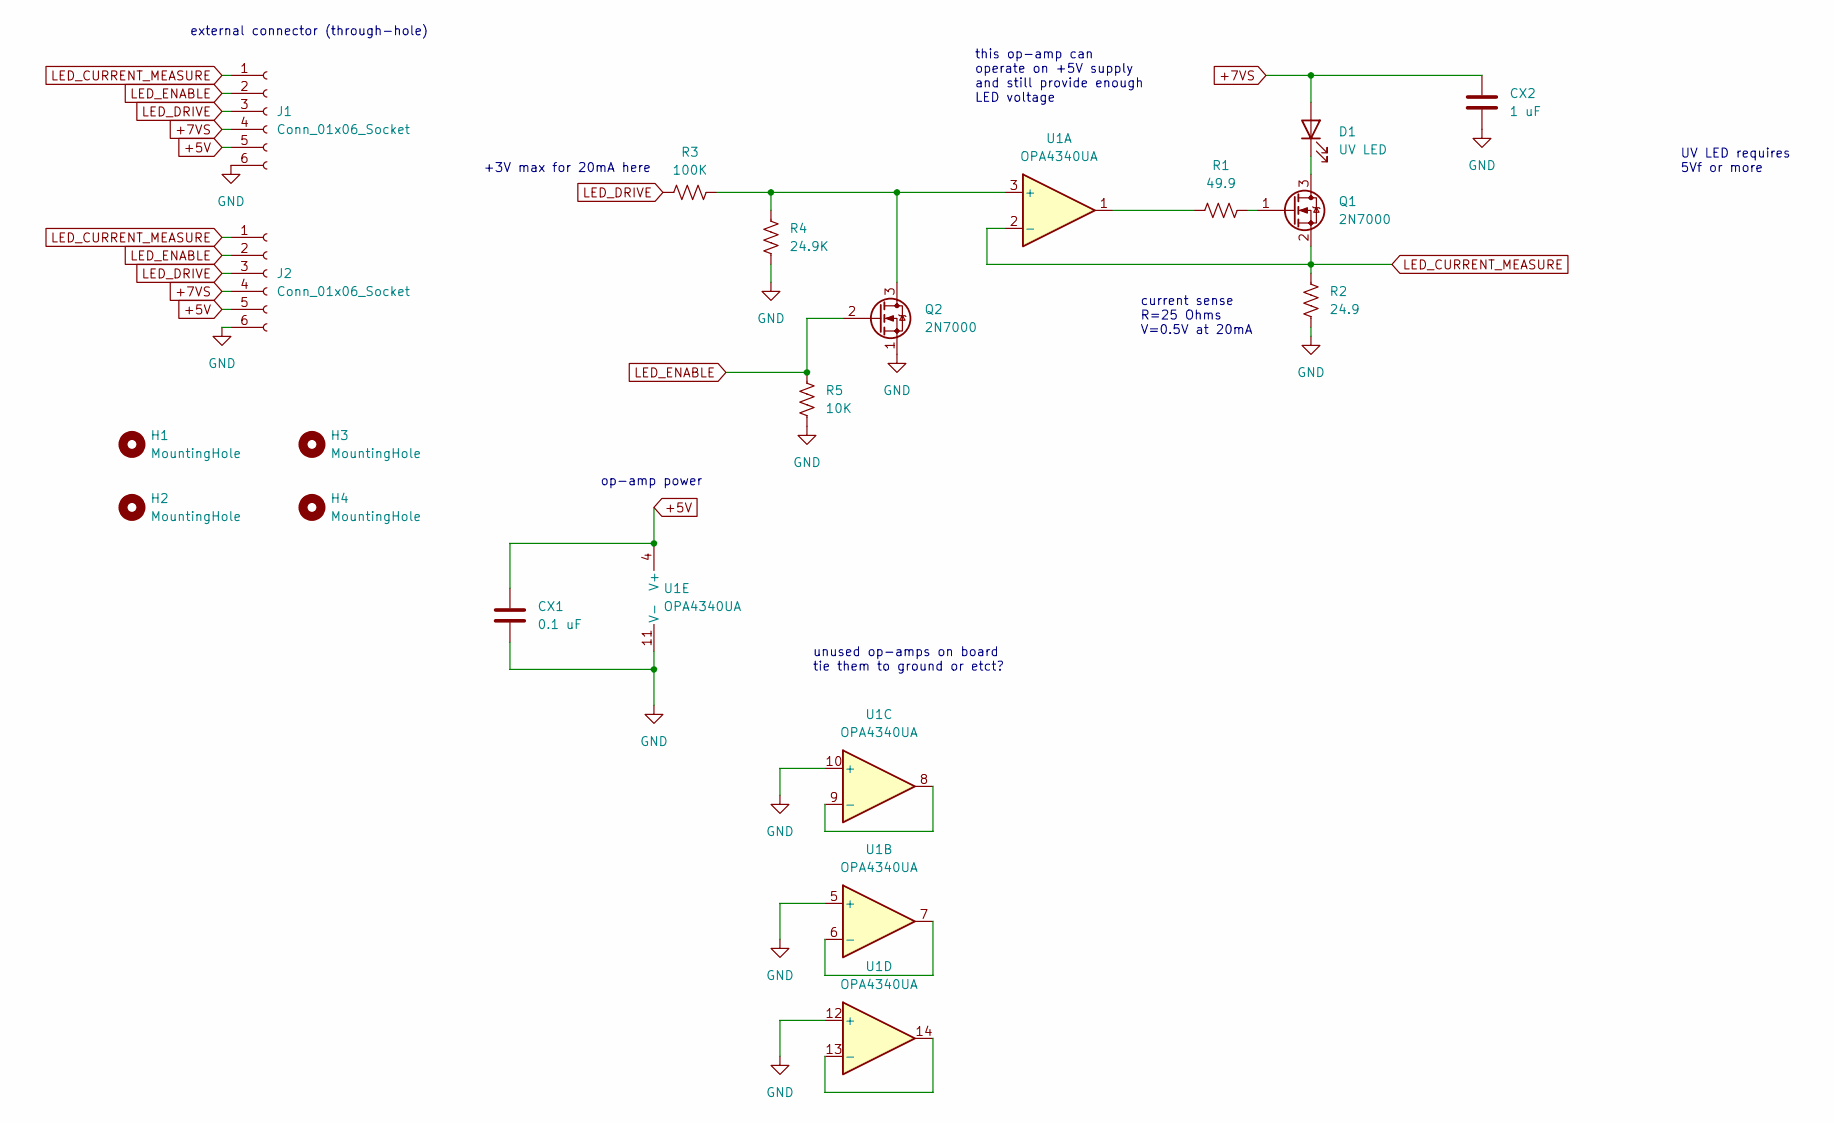
[picture p24: schematic uv-emitter.kicad_sch]

Parts:
CX1: 0.1 uF; C_0805_2012Metric_Pad1.18x1.45mm_HandSolder
CX2: 1 uF; C_0805_2012Metric_Pad1.18x1.45mm_HandSolder
D1: UV LED; LED_IN-C35PPCTGU0
H1, H2, H3, H4: MountingHole; MountingHole_3.2mm_M3
J1: Conn_01x06_Socket; PinSocket_1x06_P2.54mm_Vertical
J2: Conn_01x06_Socket; JST_PH_B6B-PH-K_1x06_P2.00mm_Vertical
Q1, Q2: 2N7000; SOT-23
R1: 49.9; R_0805_2012Metric_Pad1.20x1.40mm_HandSolder
R2: 24.9; R_0805_2012Metric_Pad1.20x1.40mm_HandSolder
R3: 100K; R_0805_2012Metric_Pad1.20x1.40mm_HandSolder
R4: 24.9K; R_0805_2012Metric_Pad1.20x1.40mm_HandSolder
R5: 10K; R_0805_2012Metric_Pad1.20x1.40mm_HandSolder
U1: OPA4340UA; SOIC-14_3.9x8.7mm_P1.27mm

Connections:
+5V: CX1.1, J1.5, J2.5, U1.4 (V+)
+7VS: CX2.1, D1.2 (A), J1.4, J2.4
GND: CX1.2, CX2.2, J1.6, J2.6, Q2.1 (S), R2.1, R4.1, R5.1, U1.5 (+), U1.10 (+), U1.11 (V-), U1.12 (+)
LED_CURRENT_MEASURE: J1.1, J2.1, Q1.2 (S), R2.2, U1.2 (-)
LED_DRIVE: J1.3, J2.3, R3.1
LED_ENABLE: J1.2, J2.2, Q2.2 (G), R5.2
unnamed: D1.1 (K), Q1.3 (D)
unnamed: Q1.1 (G), R1.2
unnamed: Q2.3 (D), R3.2, R4.2, U1.3 (+)
unnamed: R1.1, U1.1
unnamed: U1.6 (-), U1.7
unnamed: U1.8, U1.9 (-)
unnamed: U1.13 (-), U1.14

Notes on the sheet:
+3V max for 20mA here
UV LED requires 5Vf or more
external connector (through-hole)
this op-amp can operate on +5V supply and still provide enough LED voltage
current sense R=25 Ohms V=0.5V at 20mA
unused op-amps on board tie them to ground or etct?
op-amp power

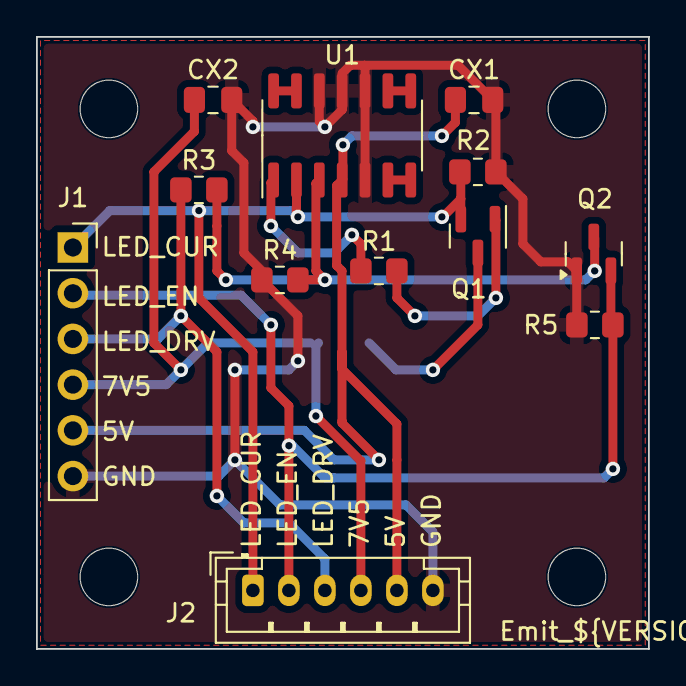
[picture p25: board uv-emitter.kicad_pcb from above]

Board: 2 copper layers, 34.0 x 34.0 mm, 17 parts (1 on the bottom side), 13 nets.
