edgecollective/uv254/(commit log)

2026-11-06 Add CERN-OHL-S-2.0 license, .gitignore and .gitattributes
    Added before the board history is imported so that every tagged
    revision carries the license text.
2026-11-06 uv-control firmware: CircuitPython scripts and libraries
    Imported from uv-water@f4cb0ad:uv-water-sensor/UV-Control/firmware.
2026-11-06 uv-control v0.1_A+: board edits after v0.1_A was sent
    Imported from uv-water@a1500f1:uv-water-sensor/UV-Control/v_0.1_A/UV-Control.
    Board edits made after v0.1_A was sent to Josh.
    [uv-control.kicad_pcb]
2026-11-06 uv-emitter v0.3: JLCPCB order (Aug 2024)
    Imported from uv-water@9910dac:uv-water-sensor/UV-LED-source/v_0.3.
    Fabrication files are in fab/v0.3/. Regenerating them from this board with kicad-cli 8.0.6 reproduces their geometry; see fab/v0.3/README.md.
    Ordered from JLCPCB on 2024-08-19. The KiCad project file (.kicad_pro) for this revision was never committed upstream; open the .kicad_pcb / .kicad_sch directly.
    [UV-LED-source-B_Cu.gbr, UV-LED-source-B_Mask.gbr, UV-LED-source-B_Paste.gbr, UV-LED-source-B_Silkscreen.gbr, UV-LED-source-Edge_Cuts.gbr, UV-LED-source-F_Cu.gbr, UV-LED-source-F_Mask.gbr, UV-LED-source-F_Paste.gbr]
2026-11-06 uv-emitter v0.2_A: revision branched from v0.2 (2026)
    Imported from uv-water@a1500f1:uv-water-sensor/UV-LED-source/v_0.2_A/UV-LED-source.
    Branched from v0.2 (started 2026-06-26, last edited 2026-10-25).
    [uv-emitter.kicad_pcb, uv-emitter.kicad_sch]
2026-11-06 uv-emitter v0.2: fab release (Apr 2024)
    Imported from uv-water@01dbf73:uv-water-sensor/UV-LED-source/v_0.2.
    Fabrication files are in fab/v0.2/. Regenerating them from this board with kicad-cli 8.0.6 reproduces their geometry; see fab/v0.2/README.md.
    [UV-LED-source-B_Cu.gbr, UV-LED-source-B_Mask.gbr, UV-LED-source-B_Paste.gbr, UV-LED-source-B_Silkscreen.gbr, UV-LED-source-Edge_Cuts.gbr, UV-LED-source-F_Cu.gbr, UV-LED-source-F_Mask.gbr, UV-LED-source-F_Paste.gbr]
2026-11-06 uv-emitter v0.1: first fab release (Mar 2024)
    Imported from uv-water@e4f5e41:uv-water-sensor/UV-LED-source.
    Fabrication files are in fab/v0.1/. Regenerating them from this board with kicad-cli 8.0.6 reproduces their geometry; see fab/v0.1/README.md.
    First UV LED emitter board.
    [UV-LED-source-B_Cu.gbr, UV-LED-source-B_Mask.gbr, UV-LED-source-B_Paste.gbr, UV-LED-source-B_Silkscreen.gbr, UV-LED-source-Edge_Cuts.gbr, UV-LED-source-F_Cu.gbr, UV-LED-source-F_Mask.gbr, UV-LED-source-F_Paste.gbr]
2026-11-06 uv-detector v0.3: JLCPCB order (Aug 2024)
    Imported from uv-water@9910dac:uv-water-sensor/UV-Detector/v_0.3.
    Ordered from JLCPCB on 2024-08-19. The KiCad project file (.kicad_pro) for this revision was never committed upstream, so only the schematic and board are available; open the .kicad_pcb / .kicad_sch directly.
    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
    [UV-Detector-B_Cu.gbr, UV-Detector-B_Mask.gbr, UV-Detector-B_Paste.gbr, UV-Detector-B_Silkscreen.gbr, UV-Detector-Edge_Cuts.gbr, UV-Detector-F_Cu.gbr, UV-Detector-F_Mask.gbr, UV-Detector-F_Paste.gbr]
2026-11-06 uv-detector v0.2_A: revision sent to Josh (Jun 2026)
    Imported from uv-water@9b51ff0:uv-water-sensor/UV-Detector/v_0.2_A/UV-Detector.
    Branched from v0.2. Sent to Josh (2026-06-26).
    [uv-detector.kicad_pcb, uv-detector.kicad_sch]
2026-11-06 uv-detector v0.2: fab release (Apr 2024)
    Imported from uv-water@01dbf73:uv-water-sensor/UV-Detector/v_0.2.
    The fabricated gerbers also carry the copper text "uva-detect-v0.2" on F.Cu (x 10-28.5 mm, y 38-39 mm), which was deleted from the board before it was committed. Everything else regenerates identically.
    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
    [UV-Detector-v0.2-B_Cu.gbr, UV-Detector-v0.2-B_Mask.gbr, UV-Detector-v0.2-B_Paste.gbr, UV-Detector-v0.2-B_Silkscreen.gbr, UV-Detector-v0.2-Edge_Cuts.gbr, UV-Detector-v0.2-F_Cu.gbr, UV-Detector-v0.2-F_Mask.gbr, UV-Detector-v0.2-F_Paste.gbr]
2026-11-06 uv-detector v0.1: first fab release (Mar 2024)
    Imported from uv-water@4fa3ad2:uv-water-sensor/UV-Detector.
    First photodiode detector board.
    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
    [UV-Detector-B_Cu.gbr, UV-Detector-B_Mask.gbr, UV-Detector-B_Paste.gbr, UV-Detector-B_Silkscreen.gbr, UV-Detector-Edge_Cuts.gbr, UV-Detector-F_Cu.gbr, UV-Detector-F_Mask.gbr, UV-Detector-F_Paste.gbr]
2026-11-06 uv-control v0.1_A: revision sent to Josh (Jun 2026)
    Imported from uv-water@6cc09f1:uv-water-sensor/UV-Control/v_0.1_A/UV-Control.
    Branched from v0.1. Sent to Josh (2026-06-26).
    [uv-control.kicad_sch]
2026-11-06 uv-control v0.1: first fab release (Jul 2024)
    Imported from uv-water@7952654:uv-water-sensor/UV-Control/hardware.
    Ordered from JLCPCB on 2024-08-19 together with detector v0.3 and emitter v0.3.
    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
    [UV-Control-B_Cu.gbr, UV-Control-B_Mask.gbr, UV-Control-B_Paste.gbr, UV-Control-B_Silkscreen.gbr, UV-Control-Edge_Cuts.gbr, UV-Control-F_Cu.gbr, UV-Control-F_Mask.gbr, UV-Control-F_Paste.gbr]
2026-11-06 uv-detector v0.4: work in progress, derived from v0.2_B
    Imported from uv-water@7e824ac:uv-water-sensor/UV-Detector/v_0.3/uv-detector.
    Work in progress, derived from v0.2_B. Called "v0.3" in the uv-water repo; renumbered to v0.4 because v0.3 was already used by the 2024 JLCPCB order. Silkscreen still reads "uva-detect-v0.3" / "Detect_0.3".
    [uv-detector.kicad_pcb, uv-detector.kicad_sch]
2026-11-06 uv-emitter v0.4: work in progress, derived from v0.2_A
    Imported from uv-water@7e824ac:uv-water-sensor/UV-LED-source/v_0.3/uv-led-source.
    Work in progress, derived from v0.2_A. Called "v0.3" in the uv-water repo; renumbered to v0.4 because v0.3 was already used by the 2024 JLCPCB order. Silkscreen still reads "uva-emitter-v0.3".
    [uv-emitter.kicad_pcb, uv-emitter.kicad_sch]
2026-11-06 uv-detector v0.2_B: revision following v0.2_A (2026)
    Imported from uv-water@a1500f1:uv-water-sensor/UV-Detector/v_0.2_B/UV-Detector.
    Follows v0.2_A.
    [uv-detector.kicad_pcb, uv-detector.kicad_sch]
2026-11-06 Move custom parts into a shared lib/uv254 library
    All three boards now use a single project library, lib/uv254.kicad_sym and
    lib/uv254.pretty. Each board's sym-lib-table and fp-lib-table point to it
    through ${KIPRJMOD}/../../lib, so a fresh clone opens with no global KiCad
    library setup.
    Only the parts used by the current designs were kept:
    symbols: 555_nicepins (was uvcontrol), SD008-2171-112 (was symbols),
    itsybitsy_nrf52840_express, ssd1306 (were lucc)
    footprints: itsybitsy, ssd1306_b (were lucc),
    LED_IN-C35PPCTGU0 (was footprints)
    The unused lucc parts, S5971, adafruit_qt_py and SK6812MINI are still in the
    tagged revisions.
    Library contents are byte-f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
    [uv-control.kicad_pcb, uv-control.kicad_sch, uv-detector.kicad_sch, uv-emitter.kicad_pcb, uv-emitter.kicad_sch]
2026-11-06 lib: fix default footprints of the ItsyBitsy and SSD1306 symbols
    itsybitsy_nrf52840_express and ssd1306 defaulted to Module:Adafruit_Feather,
    so a newly placed symbol got the wrong footprint. They now default to
    uv254:itsybitsy and uv254:ssd1306_b, the footprints already used on the
    control board. The schematic's cached copies were updated to match
    (equivalent to "Update symbol from library"); ERC and the netlist are
    unchanged.
    [uv-control.kicad_sch]
2026-11-06 Add docs, fab build script and KiCad CI
    - README: what the three boards are, the repository layout, and how
    versions, tags and fab folders fit together.
    - CONTRIBUTING: KiCad 10.0.x for everyone, library rules, how to work
    together without merging KiCad files, checks, and the release process.
    - hardware/<board>/README.md: revision history per board.
    - lib/README.md: library contents and known metadata issues.
    - firmware/uv-control/README.md: how to run the CircuitPython scripts.
    - scripts/build-fab.sh: gerbers + drill (from the board's saved plot
    settings), gerber zip, BOM, positions, schematic PDF, ERC/DRC reports and
    an optional interactive BOM. Refuses to run if drill marks are en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
2026-11-06 Upgrade boards and library to KiCad 10.0
    Converted with kicad-cli 10.0.8 (sch/pcb/sym/fp upgrade): the three
    schematics and boards, lib/uv254.kicad_sym, and the footprints in
    lib/uv254.pretty (including ssd1306_b, which was still KiCad 6 format).
    From here on these files need KiCad 10.
    Checked that the upgrade changes nothing in the design:
    - KiCad 10 run on the files before and after the upgrade gives identical
    netlists, ERC and DRC results (including schematic parity), and gerber
    geometry.
    - Netlists from KiCad 8 (old files) and KiCad 10 (new files) match: same
    components, values, footprints and connectivity.
    - Gerbers from KiCad 8 and KiCad 10 match geometrically.
    - KiCad 10 resolv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
    [uv-control.kicad_pcb, uv-control.kicad_sch, uv-detector.kicad_pcb, uv-detector.kicad_sch, uv-emitter.kicad_pcb, uv-emitter.kicad_sch]
2026-11-06 added pours
    [uv-detector.kicad_pcb]
2026-11-07 Fill in the emitter and detector title blocks
    Title, date, company, repository URL and license, in both the schematic
    and the PCB. The revision is ${VERSION}, a new project text variable
    (v0.4), so the schematic and board show the same version and it's set in
    one place (Schematic Setup > Project > Text Variables).
    Netlist, ERC and DRC results are unchanged.
    [uv-detector.kicad_pcb, uv-detector.kicad_sch, uv-emitter.kicad_pcb, uv-emitter.kicad_sch]
2026-11-07 Add schematic, layout and 3D images to the board READMEs
    scripts/render-images.sh <board> renders the schematic (PDF and PNG), the
    PCB layout (front, and back mirrored) and 3D views (front and back) into
    hardware/<board>/docs/, and keeps an image section in the board's README
    up to date. It pins KiCad's default colour theme so the images don't
    depend on personal preferences, and only replaces files whose picture
    changed, so re-running on an unchanged board leaves git clean.
    Images for uv-emitter and uv-detector. CONTRIBUTING describes the script
    and adds it to the release steps, and corrects the 3D model note: the
    KiCad AppImage does include the 3D model library.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
2026-11-07 uv-control: fill in the title block and add README images
    Same title block as the other boards. VERSION is v0.1_A+, the name this
    repository already uses for the design on main: v0.1_A plus the board
    edits made after it was sent. Netlist, ERC and DRC are unchanged.
    [uv-control.kicad_pcb, uv-control.kicad_sch]
2026-11-07 Add download links for the design files
    The top README and each board README link to GitHub's zip of main. It is
    the whole repository rather than one board, because the boards need the
    shared lib/ folder. The top README also shows how to download a single
    tagged revision.
2026-11-07 README: how to refresh the board images, and board thumbnails
    A new "Updating the board images" section in the top README explains
    scripts/render-images.sh: when to run it, what it writes, --fast, and
    what it needs. CONTRIBUTING and the board READMEs link to it rather than
    repeating it.
    The front page also shows each board's 3D render, linking to its README,
    so the images are visible without opening a board folder.
2026-11-07 uv-emitter: add a GND fill zone on both layers
    Refresh the layout and 3D images in the README to show it.
    [uv-emitter.kicad_pcb]
2026-11-08 uv-detector v0.4: fab release
    - GND fill kept 0.5 mm from the board edge (copper-to-edge clearance)
    - DRC clean-up: dangling vias removed, J2 pad 6 thermal relief
    (the remaining 1-spoke case on F.Cu is excluded; the pad also has a
    GND track on B.Cu)
    - Silkscreen reads Detect_0.4 / uva-detect-v0.4; release date 2026-11-08
    - Fab package in fab/v0.4, README images refreshed
    [uv-detector-B_Cu.gbr, uv-detector-B_Mask.gbr, uv-detector-B_Paste.gbr, uv-detector-B_Silkscreen.gbr, uv-detector-Edge_Cuts.gbr, uv-detector-F_Cu.gbr, uv-detector-F_Mask.gbr, uv-detector-F_Paste.gbr]
2026-11-08 uv-emitter v0.4: fab release
    - U1 (OPA4340): unused sections B, C and D wired as followers with
    their + inputs on GND, instead of left floating
    - Silkscreen version written as ${VERSION}: Emit_v0.4 / uva-emitter-v0.4;
    release date 2026-11-08
    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
    [uv-emitter-B_Cu.gbr, uv-emitter-B_Mask.gbr, uv-emitter-B_Paste.gbr, uv-emitter-B_Silkscreen.gbr, uv-emitter-Edge_Cuts.gbr, uv-emitter-F_Cu.gbr, uv-emitter-F_Mask.gbr, uv-emitter-F_Paste.gbr]
2026-11-09 uv-control v0.4: schematic draft, firmware and design notes
    First draft of the v0.4 control board schematic (ERC clean). The PCB still
    holds the v0.1_A+ layout.
    - Pro Micro nRF52840 (SuperMini) on 26 pins, including B+/B- beside USB-C;
    footprint matches the one proven on Rook v0.4
    - ADS1115 (VSSOP-10) on the board, with RC input filters, I2C and ALERT
    pull-ups and VDD decoupling
    - 8 V boost for the UV LED: TI LMR62014 with values from its datasheet,
    enable on P1.00, RC filter to the emitter
    - JST PH 6 cables to the emitter and detector, 2.0 in ST7789 TFT header,
    buttons, 3.3 V regulator for the TFT and ADC
    - Blocks drawn with wires, connected by tags (global labels)
    - lib: ProMicro_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
    [uv-control.kicad_sch]
2026-11-13 uv-control v0.4: restart from Rook v0.4; keep the first draft for reference
    The first v0.4 draft (87ac380 plus the 2026-11-13 edits) moves to
    hardware/uv-control/reference/v0.4-draft, with its schematic PDF and design
    notes.
    The board restarts from Rook v0.4's validated schematic and PCB:
    - kept: Pro Micro nRF52840, ST7789 display (1.54 in) and backlight switch,
    buttons with pull-ups, microSD
    - dropped: LoRa, GPS, OLED/Grove/Qwiic/UART/1-wire headers, battery input,
    Rook's I2C pull-ups
    - from the first draft: ADS1115 with input filters and I2C pull-ups, JST PH 6
    connectors to the detector and emitter, LED_DRIVE parts
    - new: test points TP1-TP11
    - freed Pro Micro pins: LED_ENABLE P0.22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
    [uv-control.kicad_pcb, uv-control.kicad_sch]
2026-11-14 routed detector v0.4
    [uv-control.kicad_pcb, uv-control.kicad_sch, uv-detector.kicad_pcb, uv-detector.kicad_sch, uv-emitter.kicad_sch]
2026-11-14 uv-detector v0.5: version bump, silkscreen fixes, refreshed images
    - VERSION v0.4 -> v0.5 (project and board); title blocks dated 2026-11-14
    - Silkscreen version now from ${VERSION}: uv-detect-v0.5 (front),
    uva-detect-v0.5 (back)
    - Pin-2 silkscreen labels 2V5 -> 1V8 on J1 and J2
    - README: 3.3 V / 1.8 V description, 7-pin connector pinout, v0.5 row and
    notes; top-level README detector row
    - docs/ images and schematic PDF re-rendered with scripts/render-images.sh
    - Removed the stale uv-detector.pdf (pre-v0.5 schematic; the current one is
    docs/uv-detector-schematic.pdf)
    [uv-detector.kicad_pcb, uv-detector.kicad_sch]
